Mostafaa-Amiri/smart-indoor-lighting-control-system/hardware/README.md

# Hardware Development

**Smart Indoor Lighting Control System**  
*CST Lab · University of Tehran*

## Overview

This section documents the custom lighting, sensing, control, and measurement hardware developed for the **Smart Indoor Lighting Control System**. It includes three generations of smart LED lighting panels, two LED-driver approaches, networked illuminance and occupancy sensing, capacitive wall switches, and a custom flicker-measurement instrument.

The work combines **circuit and PCB design, embedded electronics, sensing, communication interfaces, thermal design, prototyping, and experimental evaluation**. Implemented hardware and proposed designs are identified in their respective sections. Photographs, PCB renders, schematics, and block diagrams are included throughout.

## Contents

1. [Design approach](#design-approach)
2. [Smart LED lighting panels](#smart-led-lighting-panels)
3. [Smart LED drivers](#smart-led-drivers)
4. [Wi-Fi illuminance sensor](#wi-fi-illuminance-sensor)
5. [Presence sensing](#presence-sensing)
6. [Smart capacitive touch switch](#smart-capacitive-touch-switch)
7. [Flicker measurement device](#flicker-measurement-device)
8. [Related documentation](#related-documentation)

## Design Approach

Although commercial smart luminaires were considered, a custom platform better suited the research requirements:

| Design consideration | Reason for a custom implementation |
|---|---|
| **Research access and control** | Direct access to dimming, electronics and communication signals, without dependence on undocumented vendor interfaces. |
| **Cost and maintainability** | Target lower prototyping costs and enable local replacement and repair of modules. |
| **Long-term availability** | Avoid dependence on a particular manufacturer's product lifecycle or cloud infrastructure. |
| **Supply constraints** | Use accessible parts and alternative sources where importing complete products is difficult. |
| **Design flexibility** | Adjust panel geometry, output power, light distribution, color characteristics and communication architecture for experiments. |
| **System integration** | Maintain control over local communication, sensing, testing and laboratory integration. |

The goal was to develop an adaptable experimental platform with direct access to its **electrical, optical, sensing, and control characteristics**, rather than depend on fixed commercial interfaces.

## Smart LED Lighting Panels

Three principal generations were developed. **V1** explored two LED placement geometries; **V2** prioritized electrical isolation and PWM integrity; **V3** adopted a modular architecture designed for easier fabrication, cooling, servicing and power scaling.

### V1 — Integrated PCB Prototypes

The first generation integrated the **ESP32 Wi-Fi controller**, LED-driver circuitry and LED arrays on a single PCB. An I²C header was provided for connecting illuminance sensors.

Two layouts were explored:

- **Circular arrangement:** square PCB with LEDs positioned in concentric/circular patterns and angled placement.
- **Matrix arrangement:** rectangular PCB with LEDs laid out in a regular grid. The rectangular prototype was approximately **30 × 15 cm**.

This approach offered a compact, self-contained test platform without separate external control boards.

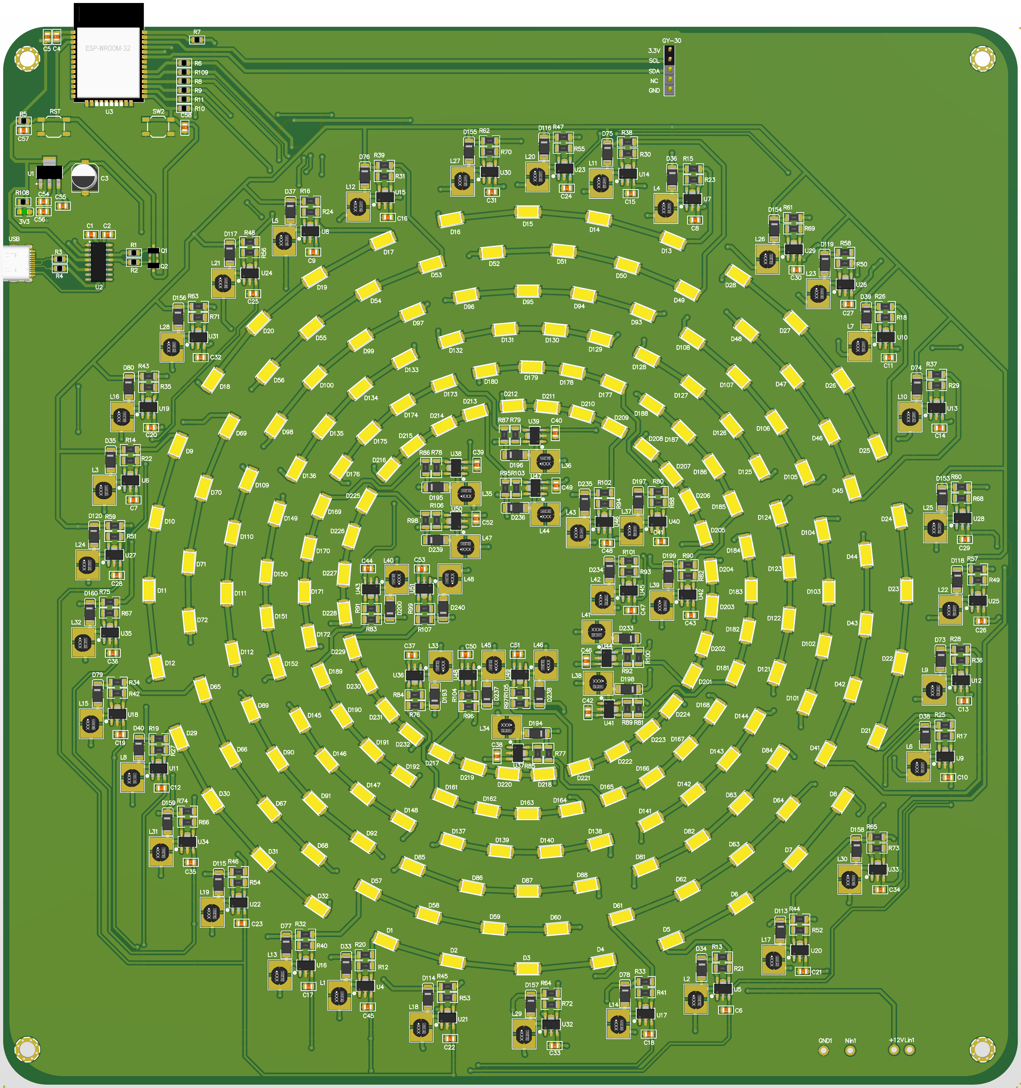
[picture p5: hardware/images/led-panel-v1/pcb-v1-3d-altium.png]
V1 layout A: circular/angled LED arrangement — 3D PCB render


*V1 layout A: circular/angled LED arrangement — 3D PCB render*

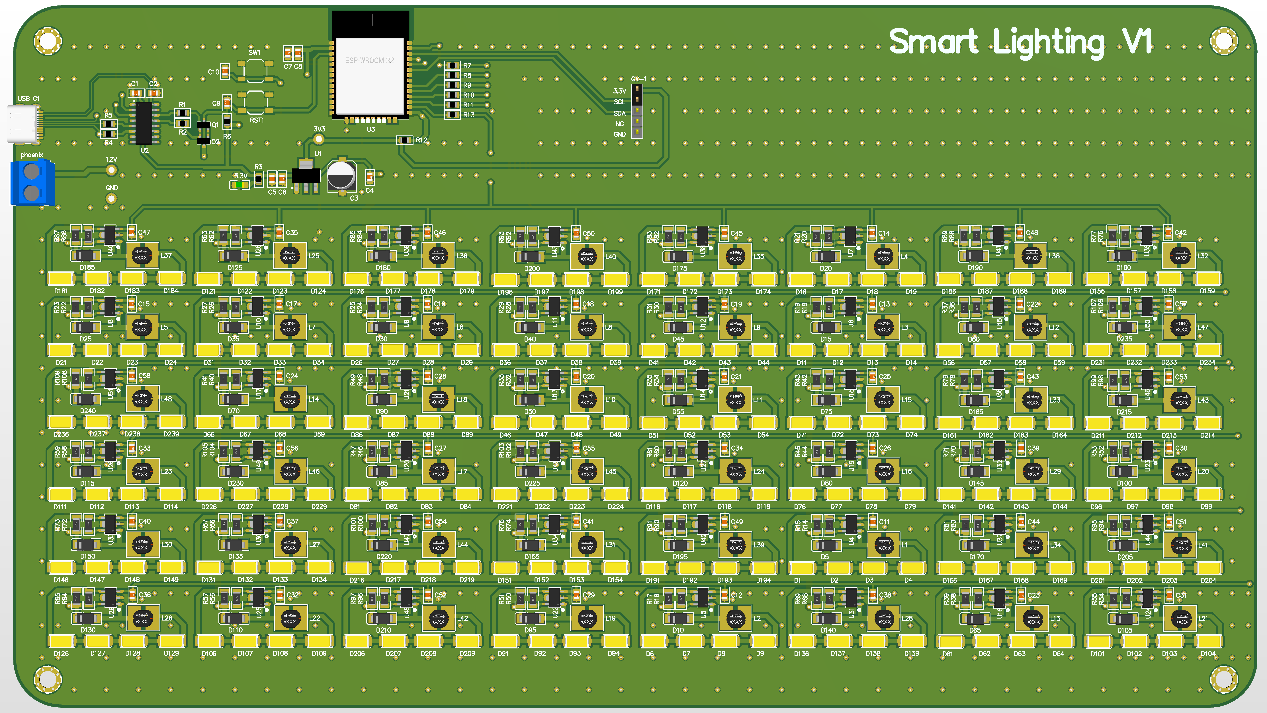
[picture p6: hardware/images/led-panel-v1/pcb-v2-3d-altium.png]
V1 layout B: rectangular LED matrix — 3D PCB render


*V1 layout B: rectangular LED matrix — 3D PCB render*

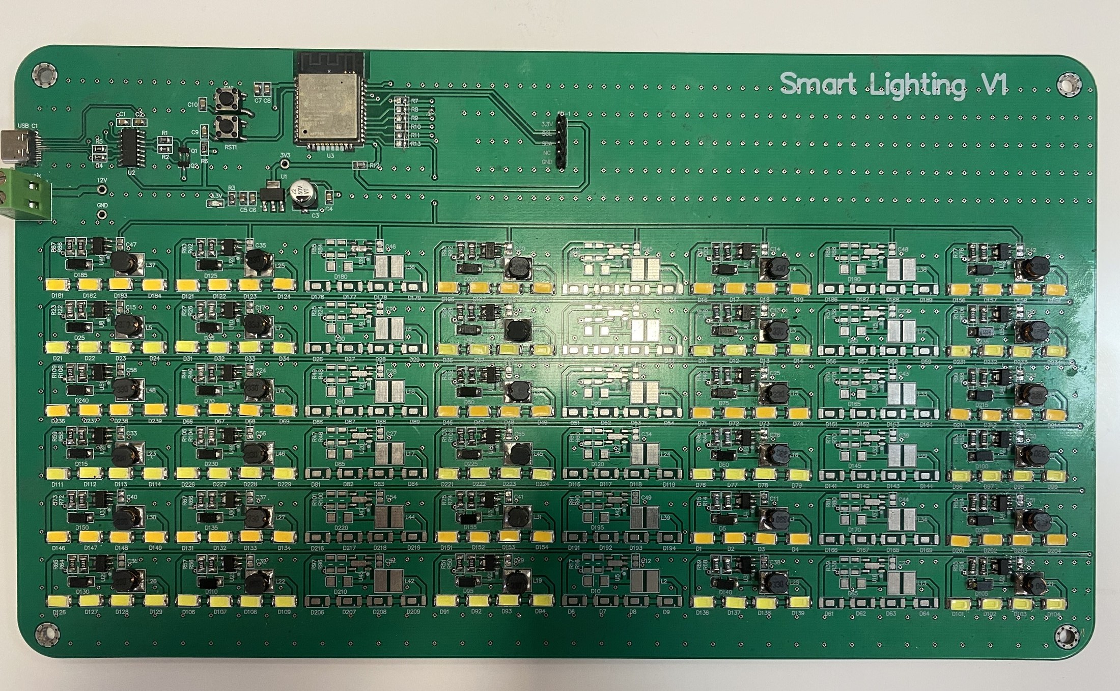
[picture p7: hardware/images/led-panel-v1/assembled-real-pcb.jpg]
First-generation PCB assembly


*First-generation PCB assembly*

**Experimental findings.** In prototype testing, visible flicker was observed and associated with interference involving the on-board Wi-Fi/control circuitry and the driver stages. The single-board architecture made control and power circuitry harder to separate. FR-4 construction without a dedicated heatsink also limited thermal management; the large, densely populated PCB was expensive and time-consuming to assemble and difficult to scale.

<details>
<summary><strong>V1 system diagram and driver schematic</strong> (2 images)</summary>

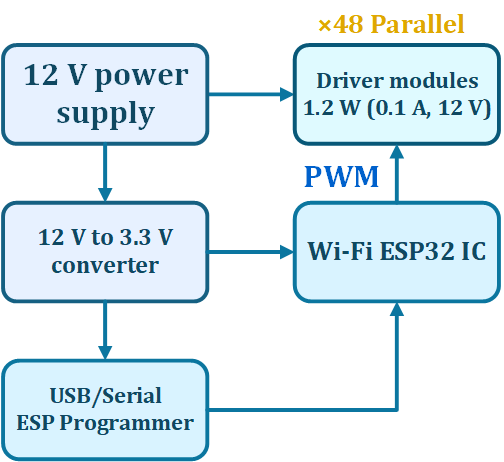
[picture p8: hardware/images/led-panel-v1/block-diagram.png]
V1 integrated power, Wi-Fi control and driver arrangement


*V1 integrated power, Wi-Fi control and driver arrangement*

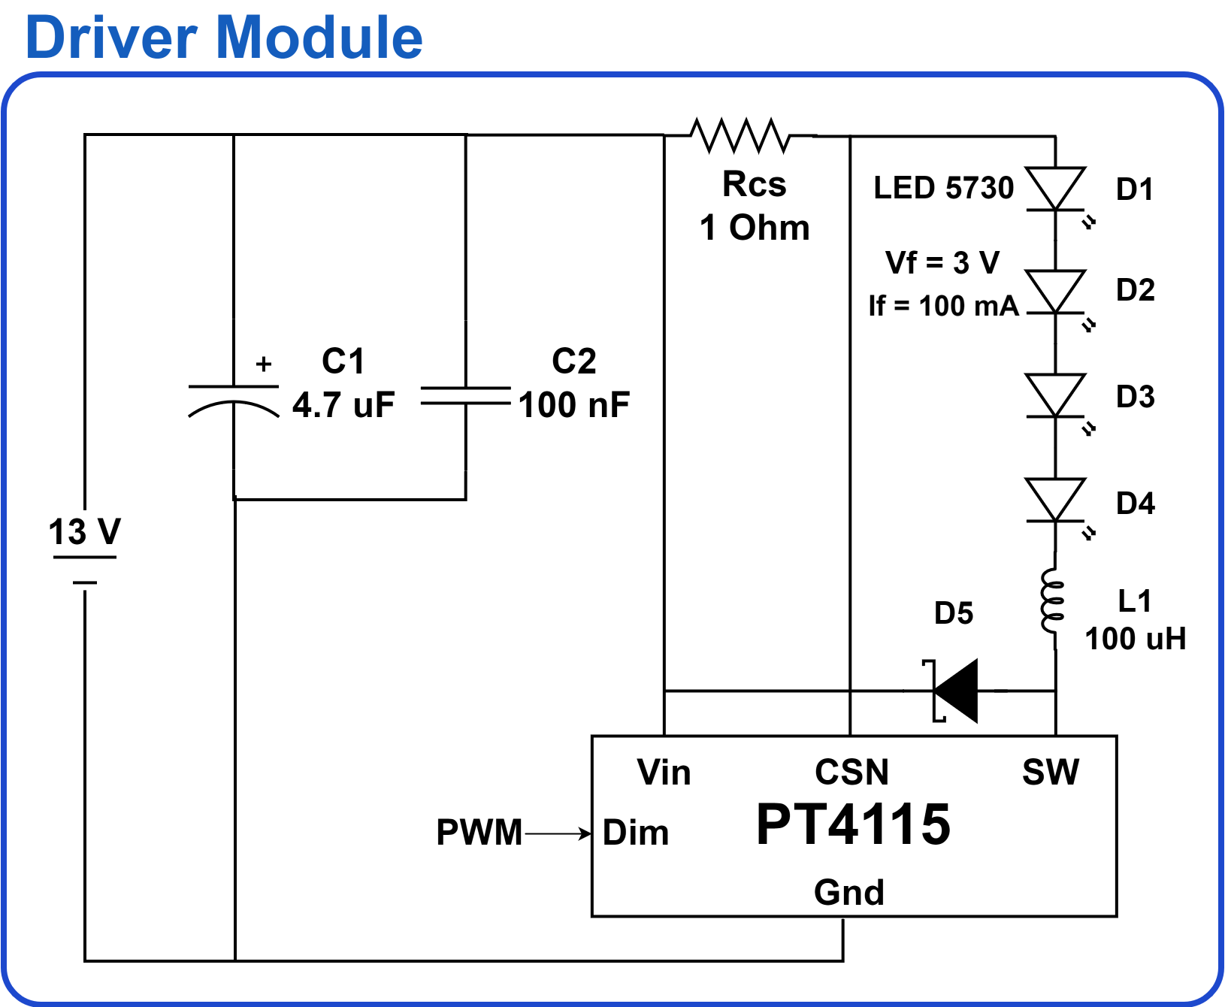
[picture p9: hardware/images/led-panel-v1/circuit-schematic.png]
Representative PT4115 driver circuit supplied for V1


*Representative PT4115 driver circuit supplied for V1*

</details>

### V2 — Isolated Control and Standardized Dimensions

The second generation moved to a **30 × 30 cm** panel and separated the Wi-Fi control electronics from the LED board. The control unit used an **ESP-12F (ESP8266)** instead of ESP32 to reduce cost.

The PWM signal was electrically isolated before reaching the LED board and then distributed through a buffer/line-driver stage. A temperature sensor was also placed on the rear of the board. The controller could **reduce dimming duty cycle (and therefore power) when elevated temperature was detected**.

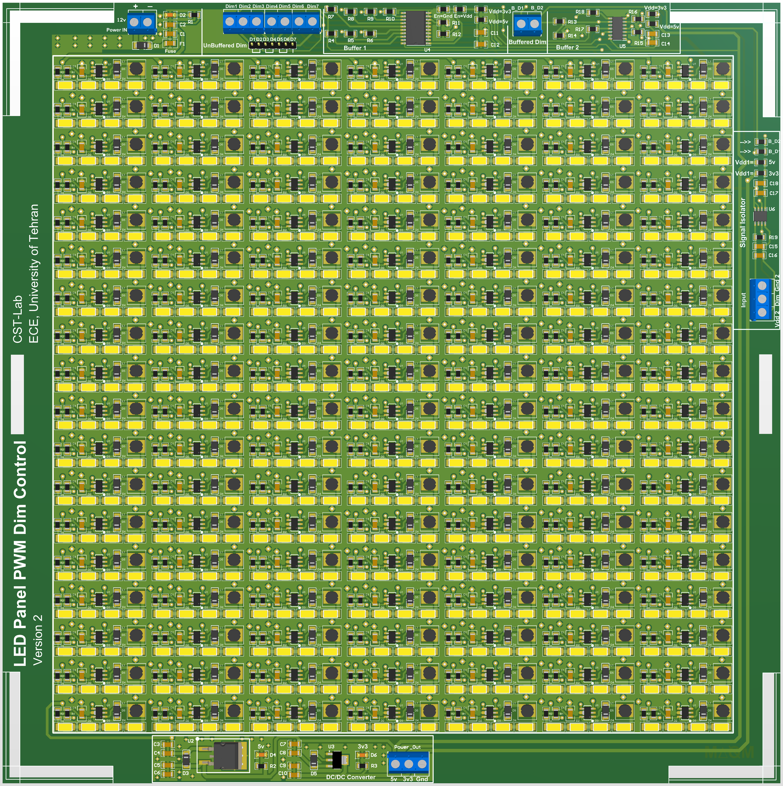
[picture p10: hardware/images/led-panel-v2/pcb-3d-altium.png]
V2 30 × 30 cm panel — Altium 3D PCB render


*V2 30 × 30 cm panel — Altium 3D PCB render*

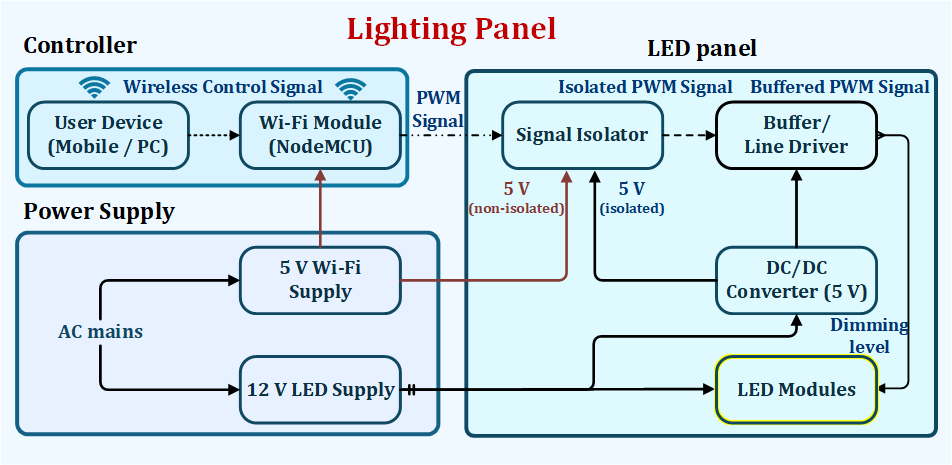
[picture p11: hardware/images/led-panel-v2/block-diagram.png]
V2 isolated Wi-Fi/PWM control and LED-board architecture


*V2 isolated Wi-Fi/PWM control and LED-board architecture*

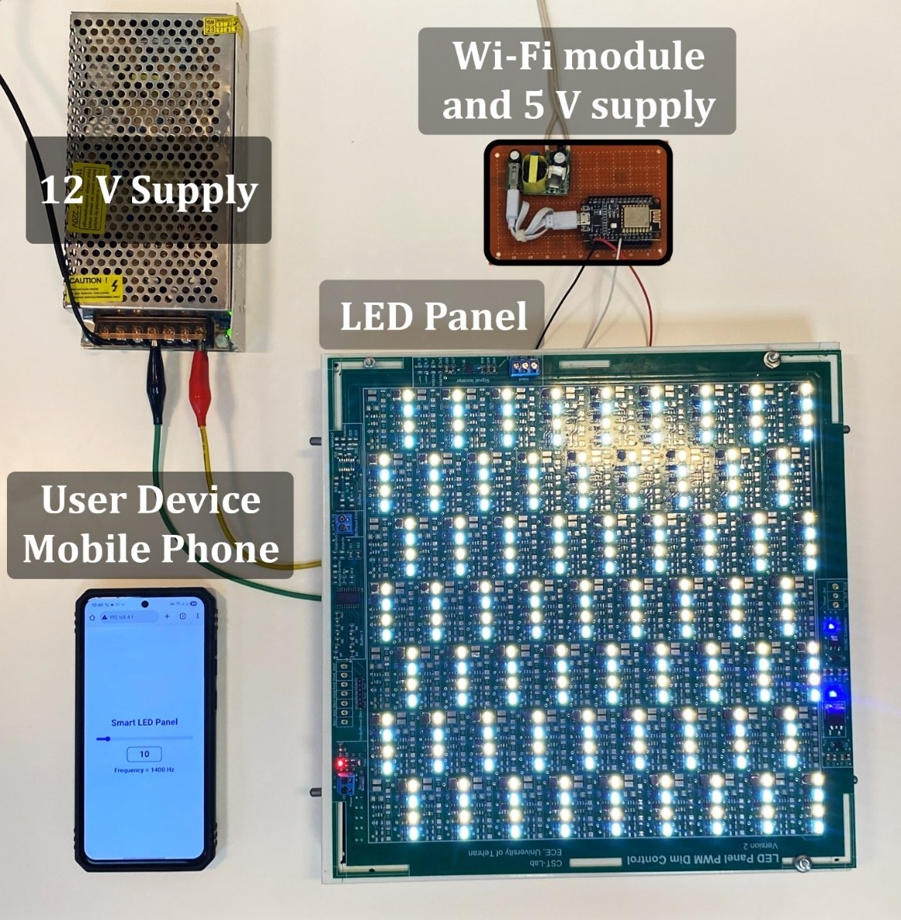
[picture p12: hardware/images/led-panel-v2/working-setup.jpg]
V2 system demonstrator: panel, controller, supply and phone


*V2 system demonstrator: panel, controller, supply and phone*

**Experimental improvements:** the redesign eliminated the previously observed RF-related visible flicker under the tested conditions, improved PWM signal integrity, provided a standard panel form factor and introduced temperature-based power reduction.

**Remaining limitations:** the large PCB, high component count and prolonged assembly made production and repair difficult. Thermal control relied on derating rather than a physical heatsink. The distributed **PT4115** driver stages were not used near their available output capability; project notes indicate approximately **1.2 W per stage**, increasing overall component count.

<details>
<summary><strong>More V2 prototype photos, PCB and schematic</strong> (5 images)</summary>

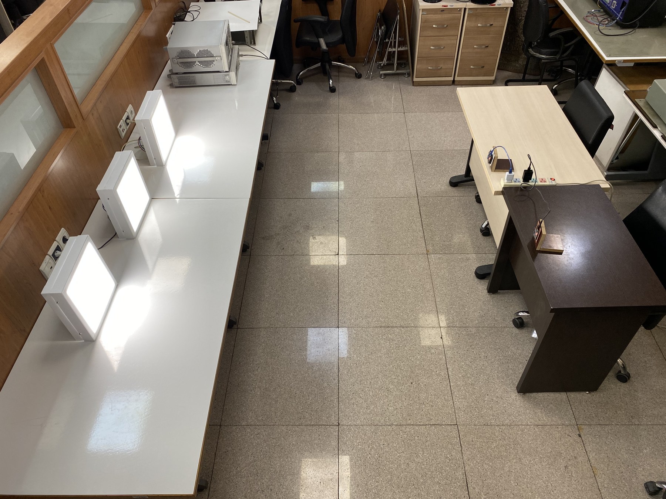
[picture p13: hardware/images/led-panel-v2/3panels-built.jpg]
Three completed panel assemblies


*Three completed panel assemblies*

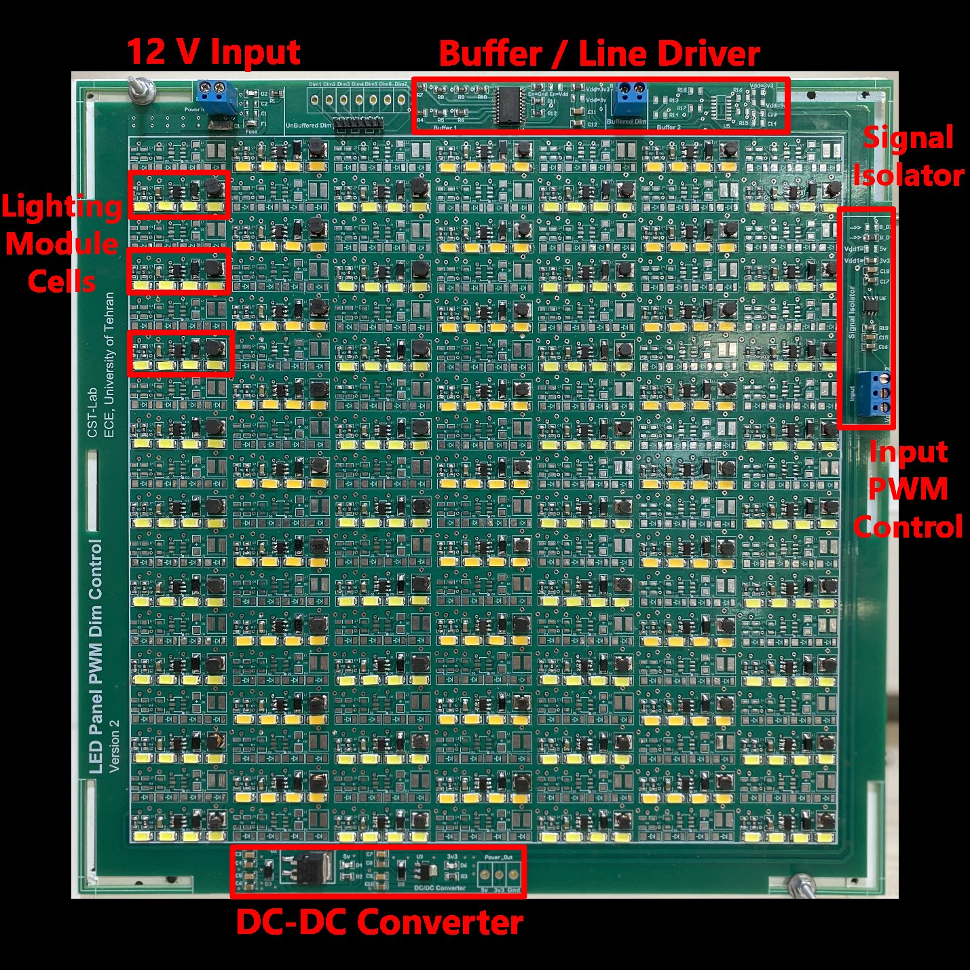
[picture p14: hardware/images/led-panel-v2/assembled-real-pcb.jpg]
Populated second-generation board


*Populated second-generation board*

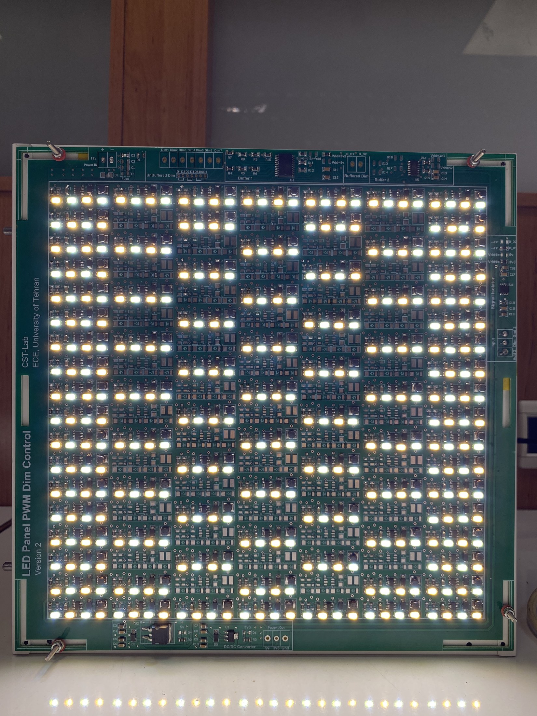
[picture p15: hardware/images/led-panel-v2/assembled-real-pcb-2.jpg]
LED array powered during tests


*LED array powered during tests*

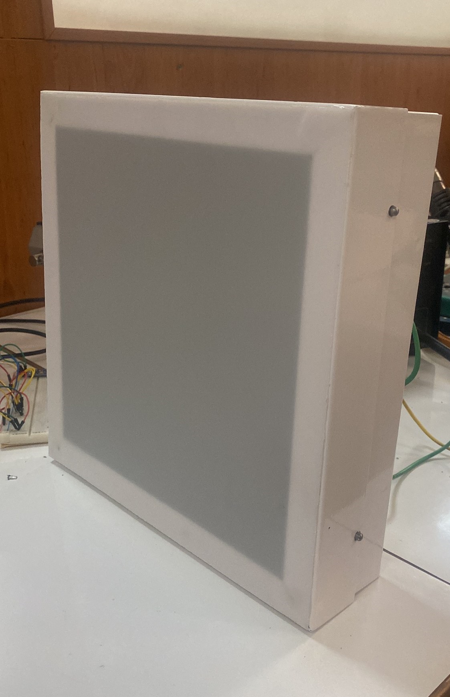
[picture p16: hardware/images/led-panel-v2/single-complete-lighting-panel.jpg]
Complete V2 luminaire with enclosure


*Complete V2 luminaire with enclosure*

Representative PT4115 driver circuit supplied for V2

*Representative PT4115 driver circuit supplied for V2*

</details>

### V3a and V3b — Modular Lighting Panels

The third generation changed the construction approach: instead of mounting many individual LED chips on a custom large-area PCB, it used **commercially available 24 V LED strips (180 LEDs/m)** on a metal heat-dissipation structure, driven by **small replaceable PT4115 constant-current driver modules**.

- **V3a:** **30 × 30 cm**.
- **V3b:** **60 × 30 cm**. The core architecture is shared; the panel size and arrangement differ.

The selected LED strip was described as having **seven series LEDs plus a series resistor per branch**. For the experimental constant-current-driven implementation, the project changed the branch resistor from approximately **180 Ω to 10 Ω** to reduce resistive losses while retaining some series resistance. This is a **prototype modification**, not a general recommendation for operating commercial constant-voltage strips without verifying current-sharing, fault behavior and thermal limits.

The separate PT4115 module was laid out with attention to short switching loops, capacitor placement, inductor/current-sense separation, PWM return routing and provision for heat dissipation.

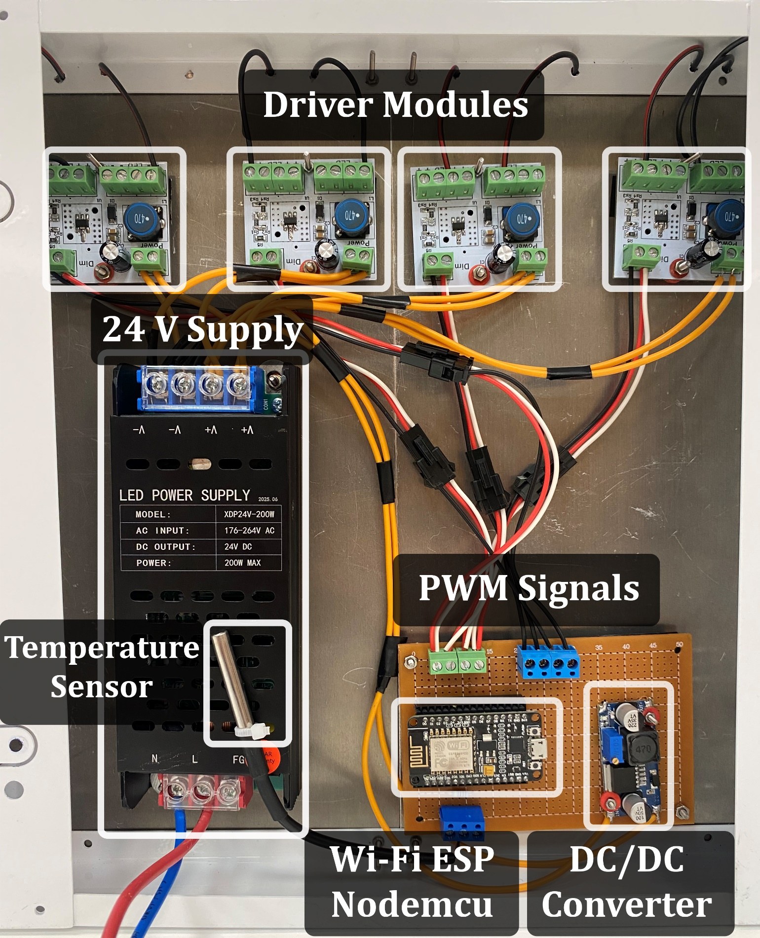
[picture p17: hardware/images/led-panel-v3a/assembled-lighting-panel.jpg]
V3a: complete modular lighting test setup


*V3a: complete modular lighting test setup*

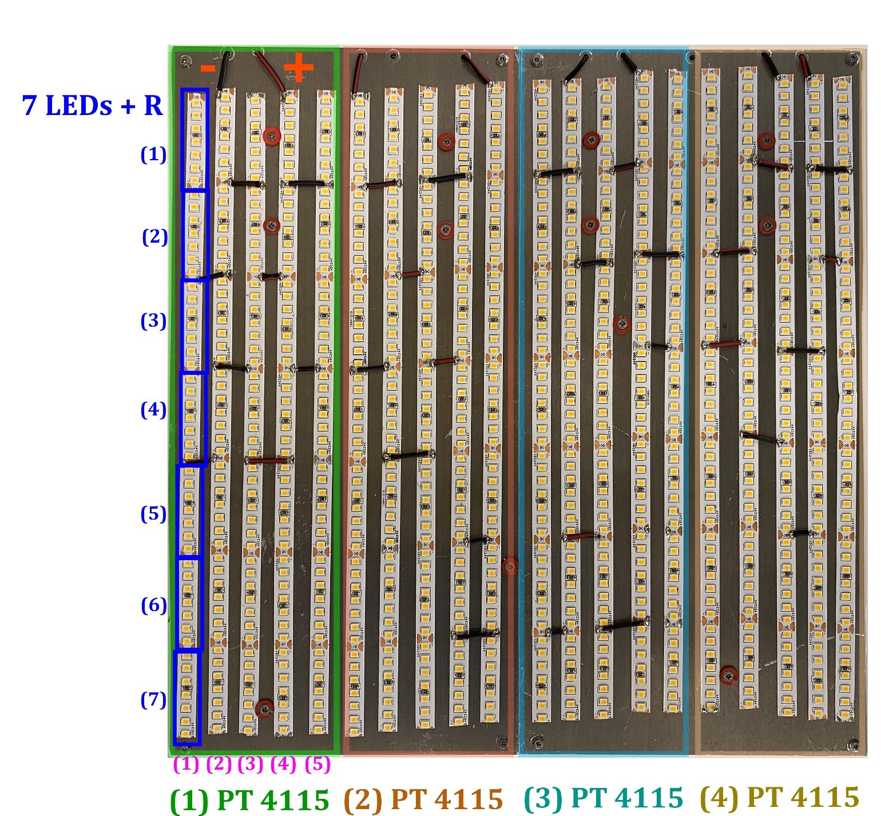
[picture p18: hardware/images/led-panel-v3a/leds-setup.jpg]
V3a: LED strips and distribution among PT4115 driver modules


*V3a: LED strips and distribution among PT4115 driver modules*

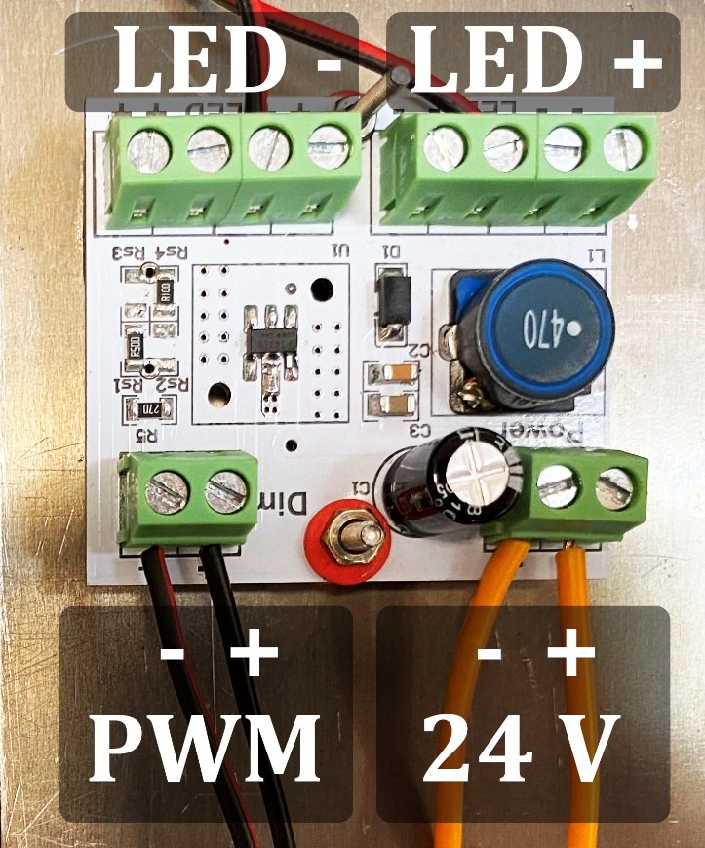
[picture p19: hardware/images/led-panel-v3a/assembled-real-pcb.jpg]
V3: small, assembled PT4115 driver module


*V3: small, assembled PT4115 driver module*

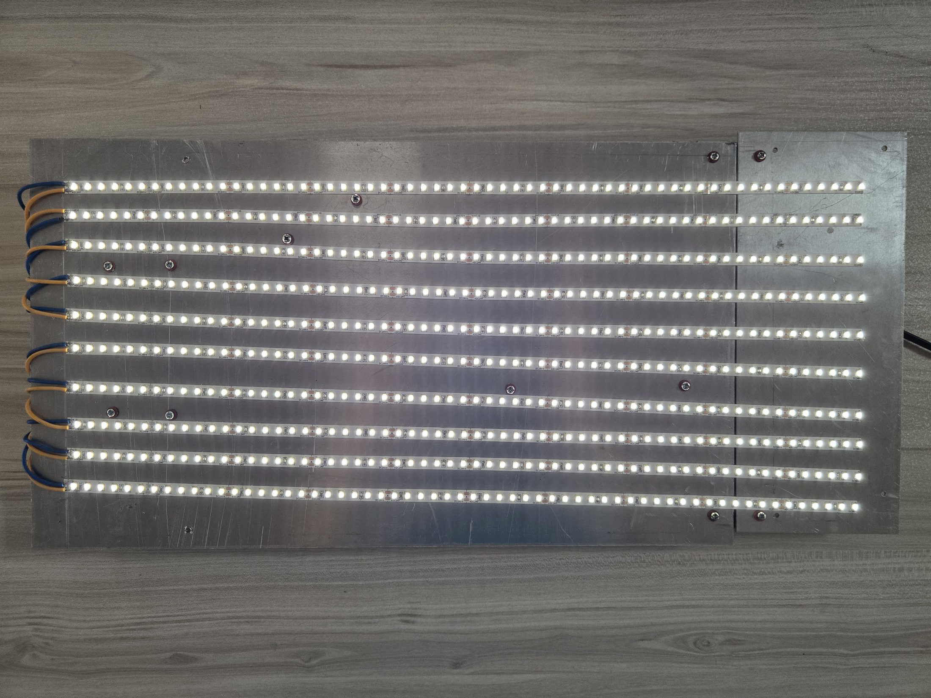
[picture p20: hardware/images/led-panel-v3b/lighting-panel-2.jpg]
V3b: 60 × 30 cm strip-based luminaire


*V3b: 60 × 30 cm strip-based luminaire*

**Engineering improvements:** lower custom-PCB area and assembly effort, simpler replacement of driver modules, heat sinking, and more flexible changes to panel size, power and LED arrangement. A separate-controller architecture also avoided the earlier co-location of Wi-Fi electronics and LED power stages.

<details>
<summary><strong>V3 driver circuit and mechanical views</strong> (2 images)</summary>

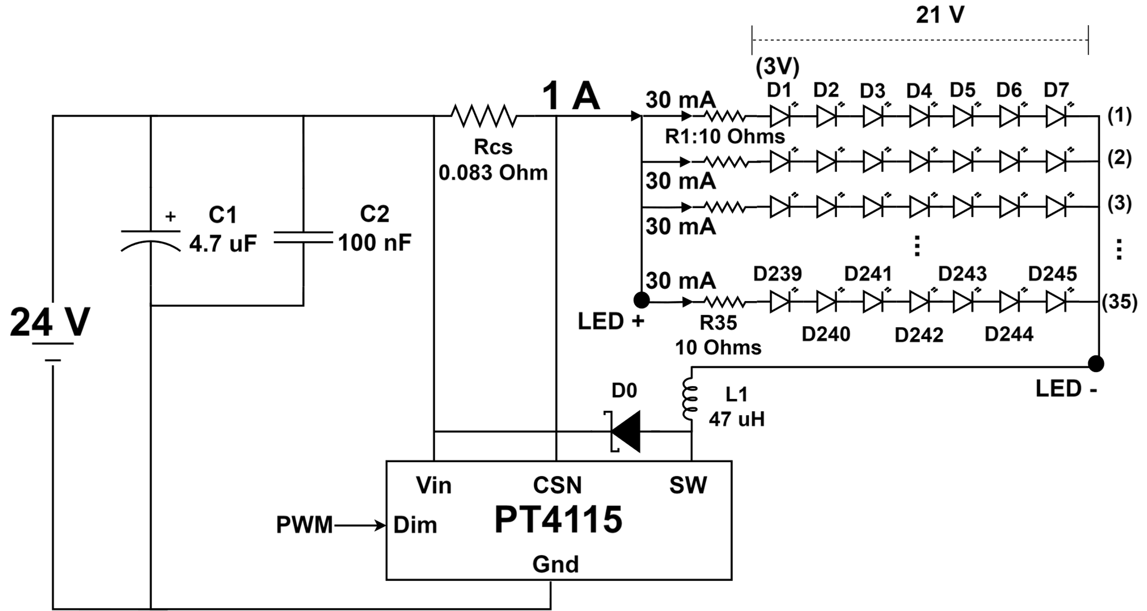
[picture p21: hardware/images/led-panel-v3a/circuit-schematic.png]
Representative V3 constant-current driver/strip branches


*Representative V3 constant-current driver/strip branches*

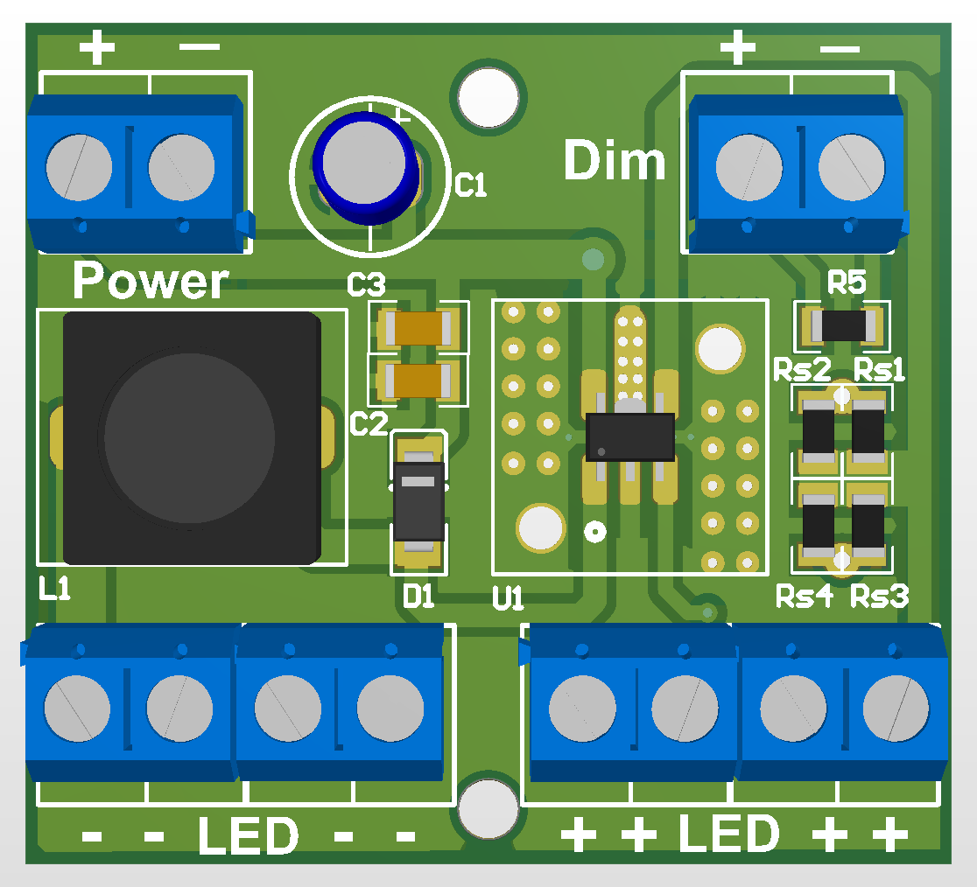
[picture p22: hardware/images/led-panel-v3a/pcb-3d-altium.png]
V3 discrete modular-driver PCB render


*V3 discrete modular-driver PCB render*

</details>

<details>
<summary><strong>V3b rear assembly</strong> (1 image)</summary>

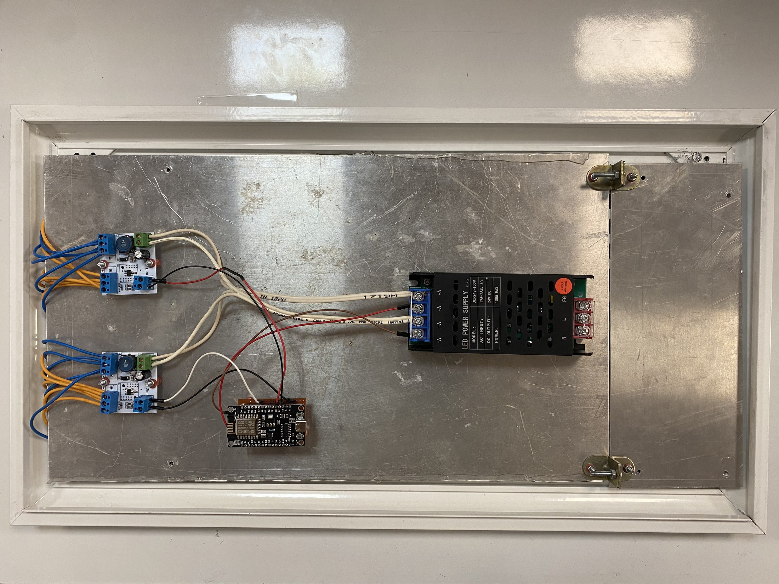
[picture p23: hardware/images/led-panel-v3b/lighting-panel.jpg]
V3b: rear of panel showing driver distribution and wiring


*V3b: rear of panel showing driver distribution and wiring*

</details>

### Experimental Comparison of Panel Generations

The following values come from the project's version-comparison notes. **Illuminance measurements are not directly comparable without documented measurement geometry and conditions**, so they are included here as reported project results rather than standardized performance ratings.

| Parameter | V1 | V2 | V3 family |
|---|---:|---:|---:|
| Reported panel power | 18 W | 36 W | 100 W |
| Reported illuminance | 120 lx | 300 lx | 650 lx |
| Thermal approach | No dedicated control | Temperature monitoring and power derating | Temperature monitoring, derating and physical heatsink |
| Visible RF-related flicker in project tests | Observed | Not observed after redesign | Not observed in reported tests |
| Reported assembly time | 2 days | 3.5 days | 1 day |
| Repairability | Difficult | Difficult | Modular replacement |
| Production suitability (qualitative) | Low | Low | Improved |

The project also recorded relative cost estimates of **4.0 million, 5.5 million, and 3.5 million** in local currency for V1, V2, and V3, respectively. These are prototype cost estimates rather than commercial quotations.

## Smart LED Drivers

Beyond building complete lighting panels, another objective was a **retrofit path for making suitable commercially available LED panels controllable via custom Wi-Fi PWM electronics**.

### Preliminary MOSFET-Based PWM Test

An initial low-cost test circuit served as a proof of concept. It used an ESP-generated PWM command and a MOSFET switching stage. **Series resistance** was used to limit LED current, including current changes associated with temperature. It was **not a regulated constant-current driver**, and therefore was not the preferred final architecture.

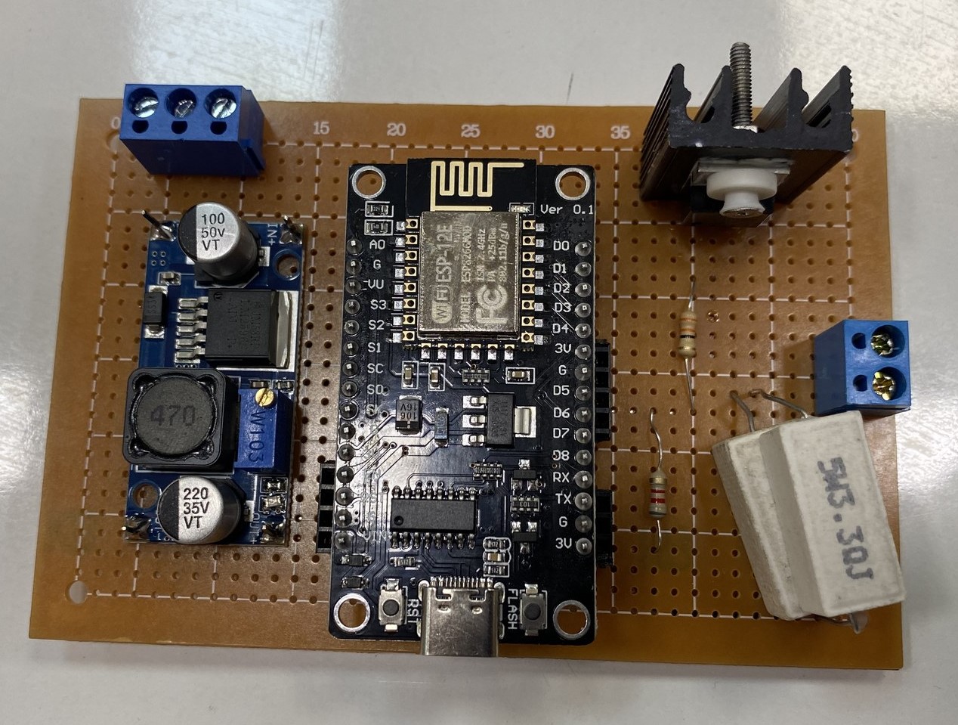
[picture p24: hardware/images/smart-driver-v1/assembled.jpg]
First low-cost PWM/MOSFET LED switching prototype


*First low-cost PWM/MOSFET LED switching prototype*

### Smart LED Lighting Panel Driver — Wi-Fi Constant-Current Design

The smart lighting panel driver integrates a high-power **constant-current LED-driver IC**, an **ESP-12F (ESP8266) Wi-Fi controller**, and an on-board **3.3 V regulator** to provide adjustable dimming for compatible LED loads. **The PCB has now been fabricated, assembled, and functionally tested with an LED lighting panel**, progressing beyond the Altium design stage.

**Electrical design parameters and control features:**

- **Input supply range:** approximately **5–60 V**, subject to device, regulator and component operating limits.
- **LED output current:** configurable **up to 2 A**, subject to electrical and thermal derating.
- **Control:** Wi-Fi-based dimming using the embedded controller.
- **Current-setting:** sense/configuration resistors set the target **LED current**. In a constant-current design, the LED-string voltage is determined by the load and available converter operating range; it is **not independently programmable by a resistor**.
- **Protection objectives:** undervoltage lockout, overcurrent and thermal protection, open/short-load handling, and controlled startup, as applicable to the selected circuitry and driver IC. These features must be verified against the final schematic and test results; they are not claimed here as independently certified.

<p align="center">
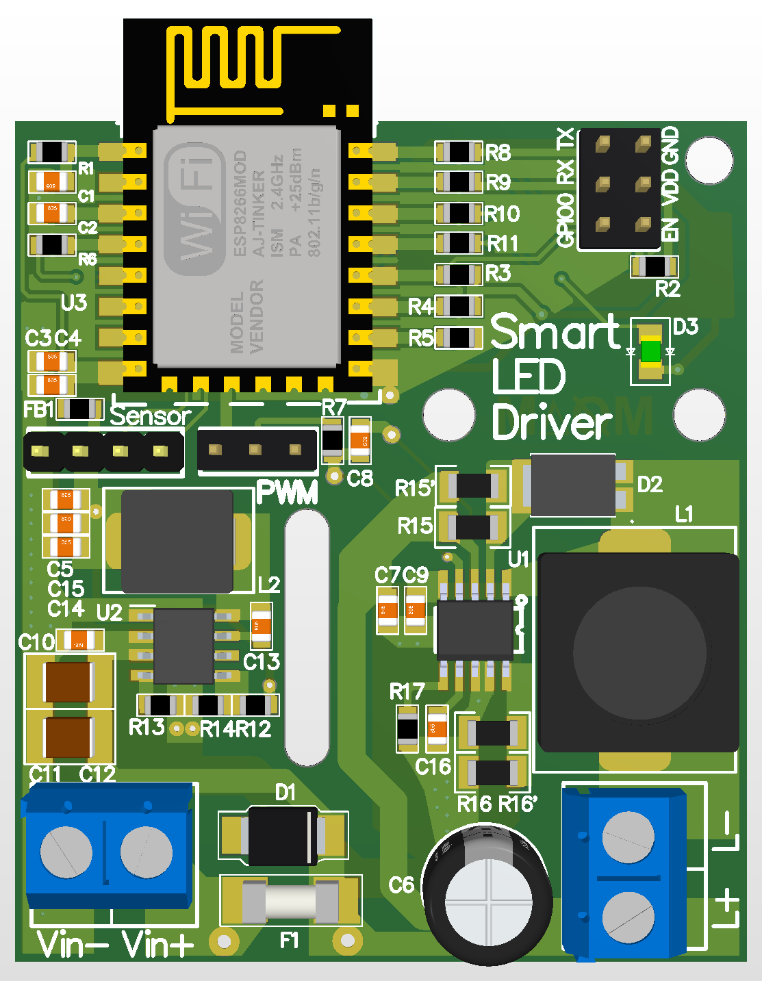
[picture p25: hardware/images/smart-driver-v2/pcb-3d-altium.png]
Altium 3D rendering of the smart LED lighting panel driver PCB
  
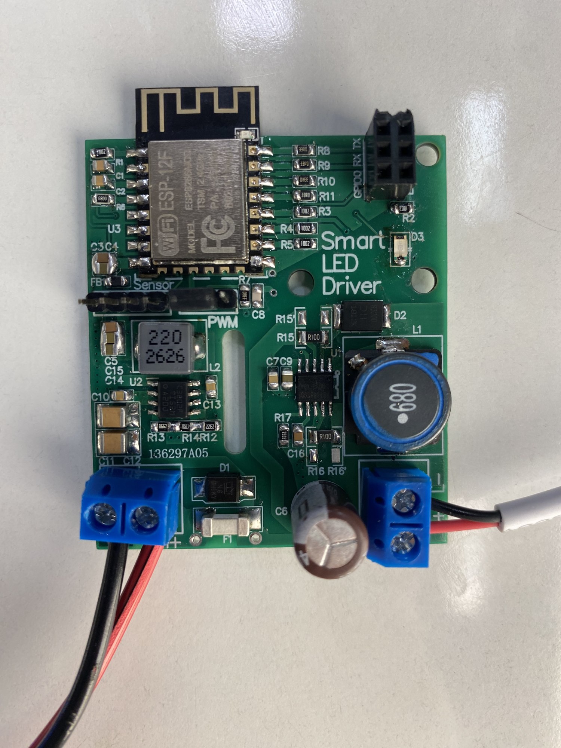
[picture p26: hardware/images/smart-driver-v2/assembled-front.jpg]
Assembled smart LED lighting panel driver PCB, component side
  
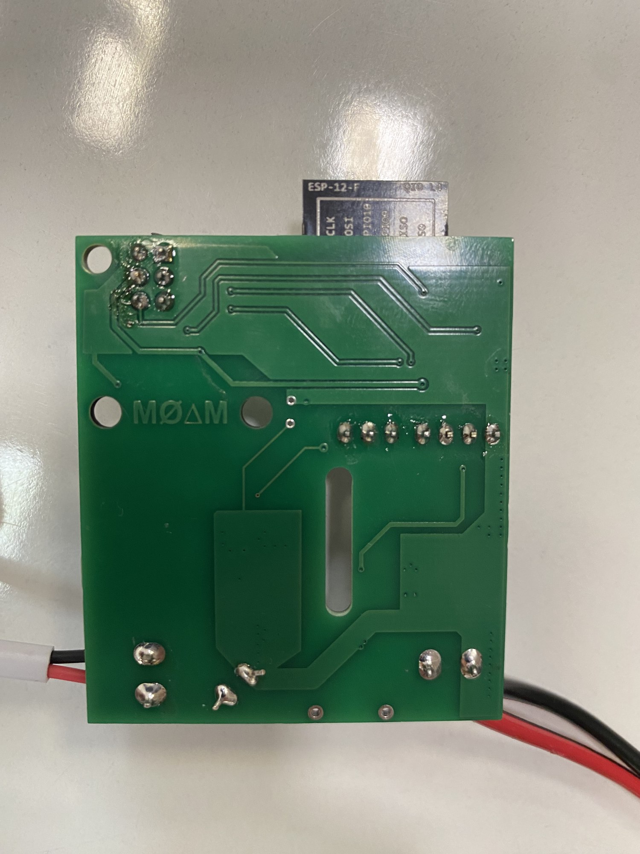
[picture p27: hardware/images/smart-driver-v2/assembled-back.jpg]
Assembled smart LED lighting panel driver PCB, solder side
  
</p>

<p align="center"><em>Smart LED lighting panel driver: Altium PCB visualization (left), assembled component side (center), and solder side (right).</em></p>

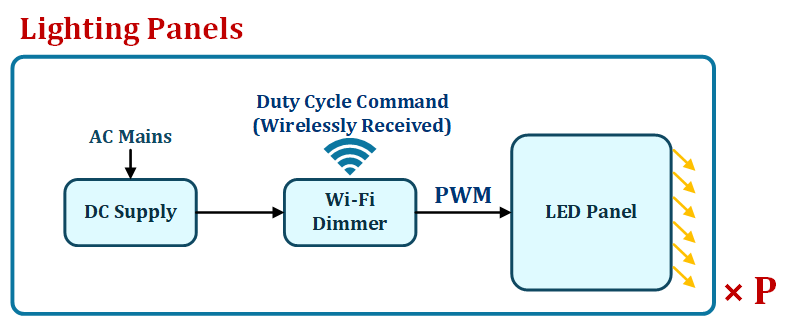
[picture p28: hardware/images/smart-driver-v2/block-diagram.png]
Wireless PWM dimming and LED-panel connection concept


*Wireless PWM dimming and LED-panel connection concept*

#### Assembly and Functional Demonstration

The assembled driver was evaluated with a connected LED panel. The photographs document the populated circuit board and the operating test setup; the accompanying video demonstrates the panel's dimming behavior. The demonstration establishes functional operation of this prototype, while the electrical ratings listed above describe design parameters rather than a fully characterized operating envelope.

<p align="center">
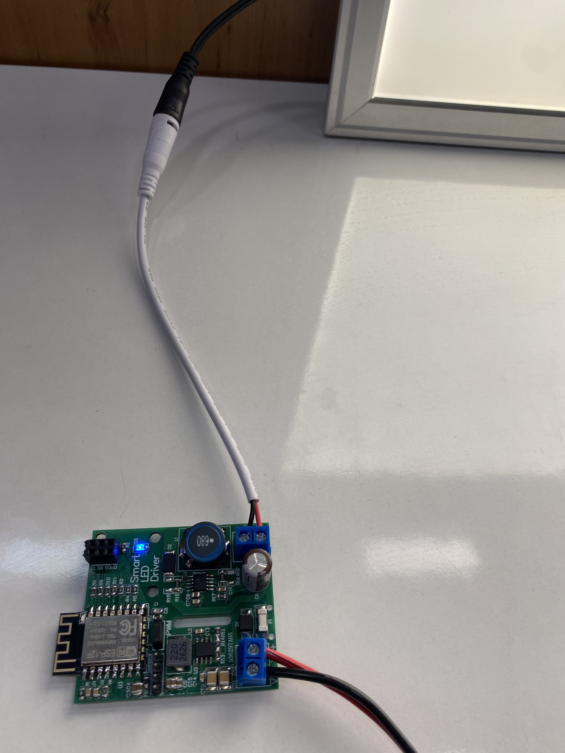
[picture p29: hardware/images/smart-driver-v2/working-test-setup-1.jpg]
Smart LED lighting panel driver connected to the LED panel during a functional test
  
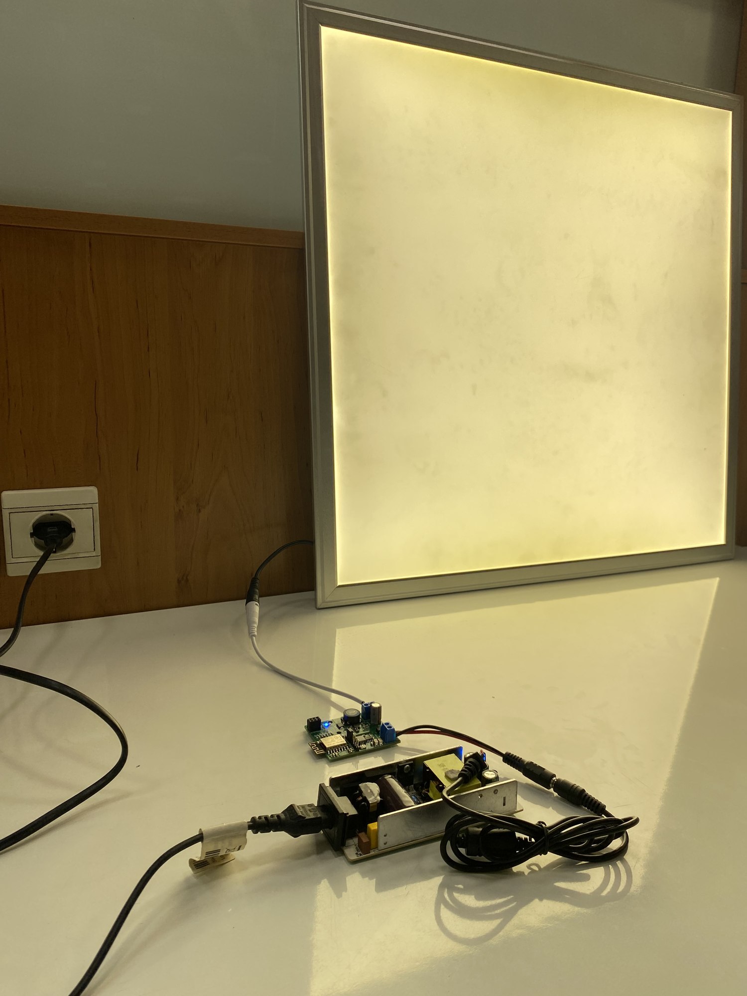
[picture p30: hardware/images/smart-driver-v2/working-test-setup-2.jpg]
Working LED panel illuminated by the assembled smart driver; click to watch the dimming demonstration
  
</p>

<p align="center"><em>Functional test of the assembled driver with an LED panel. Click the photograph on the right to watch the demonstration.</em></p>

**[Watch the smart LED lighting panel driver demonstration on YouTube](https://youtube.com/shorts/y5qzMRnB7PI?feature=share)**

## Wi-Fi Illuminance Sensor

A simple networked illuminance node uses a **BH1750/GY-30 digital lux sensor** with a **NodeMCU (ESP8266)**. The microcontroller acquires multiple illuminance samples, averages or filters the readings, and transmits them to the central gateway/controller for daylight estimation and feedback control.

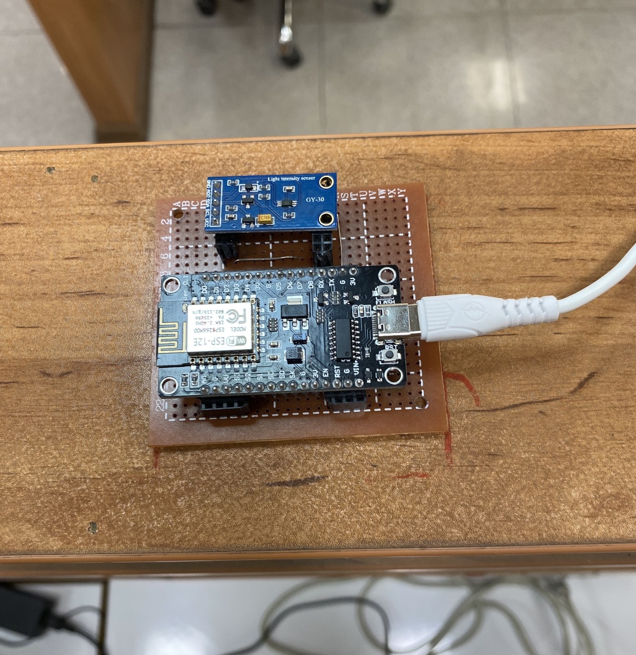
[picture p31: hardware/images/illuminance-sensor/bh1750-esp.jpg]
BH1750/GY-30 and NodeMCU Wi-Fi illuminance node


*BH1750/GY-30 and NodeMCU Wi-Fi illuminance node*

## Presence Sensing

Occupancy feedback was investigated using **mmWave radar** and **camera-based detection**. Both approaches support adaptive lighting decisions, but they have different measurement capabilities and privacy implications.

### Wi-Fi mmWave Radar Sensors

**HLK-LD2420** and **HLK-LD2450** radar modules were integrated as networked occupancy-sensing nodes. The LD2420 implementation uses an ESP8266/NodeMCU, while the LD2450 implementation uses an **ESP32** to process radar data and communicate occupancy states to the central controller.

- **LD2420:** presence and small-motion detection; the module was used for **single-target presence detection**, not multi-person tracking.
- **LD2450:** supports tracking information for **up to three targets**, including estimated positions under suitable conditions.
- **Benefit:** mmWave sensing can respond to small movements from otherwise stationary occupants, addressing some limitations of simple motion-triggered sensing.

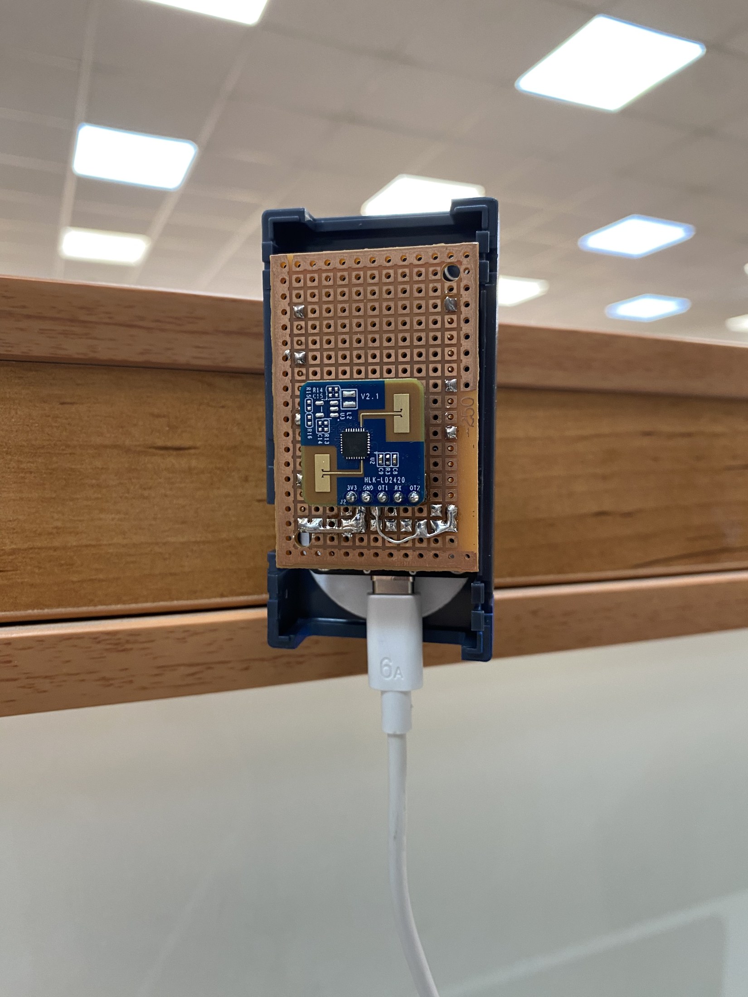
[picture p32: hardware/images/radar-presence-sensor/ld2420-esp.jpg]
LD2420 radar sensor with ESP/NodeMCU module


*LD2420 radar sensor with ESP/NodeMCU module*

#### LD2450–ESP32 Enclosed Sensor Assembly

The photographs below show the assembled **LD2450 radar and ESP32 sensing node**, including the internal electronics and the installed enclosure. Its associated firmware handles target information and publishes occupancy status to the lighting-control system.

<p align="center">
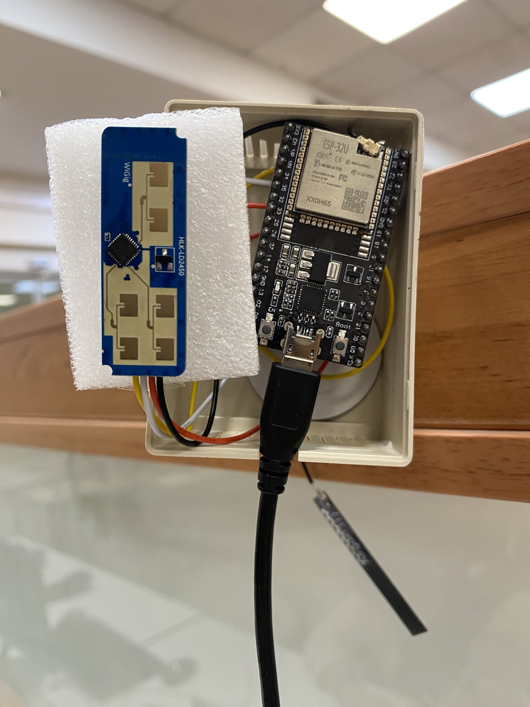
[picture p33: hardware/images/radar-presence-sensor/ld2450-esp32-open-enclosure.jpg]
LD2450 radar and ESP32 presence sensor inside the opened housing
  
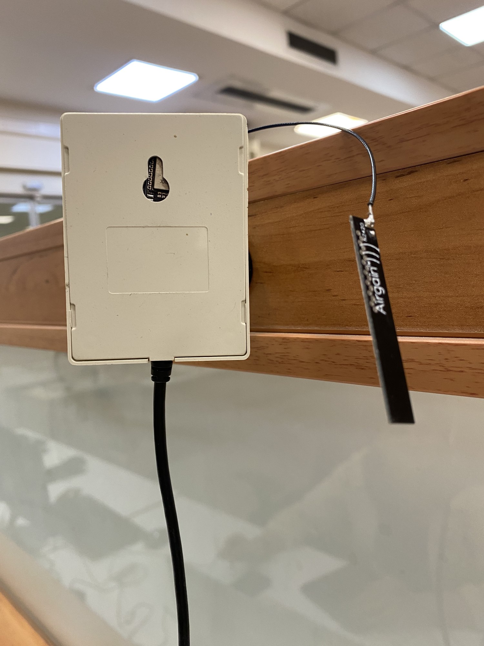
[picture p34: hardware/images/radar-presence-sensor/ld2450-esp32-closed-enclosure.jpg]
Enclosed LD2450 and ESP32 presence sensing module
  
</p>

<p align="center"><em>LD2450–ESP32 occupancy-sensing module: internal assembly (left) and closed enclosure (right).</em></p>

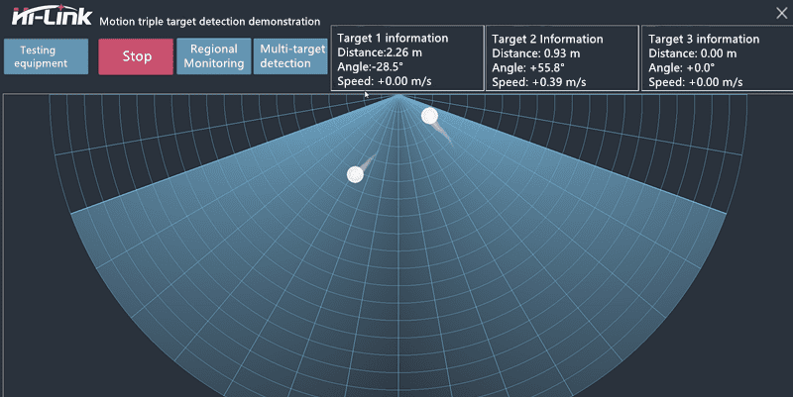
[picture p35: hardware/images/radar-presence-sensor/hilink-ui-app.png]
Hi-Link visualization of detected target positions


*Hi-Link visualization of detected target positions from the LD2450 radar sensor.*

[View the LD2450 ESP32 firmware](../firmware/README.md#multi-radar-occupancy-sensor--ld2450)

### Raspberry Pi Camera and YOLO

An alternative prototype used a **Raspberry Pi 3 with camera** and **YOLO-based people detection**. Camera-based detection can support vision-based occupancy analysis, but it creates **privacy and data-handling requirements** that do not arise in the same way with non-imaging radar. For a deployment, on-device inference, image-retention policies and user consent must be considered.

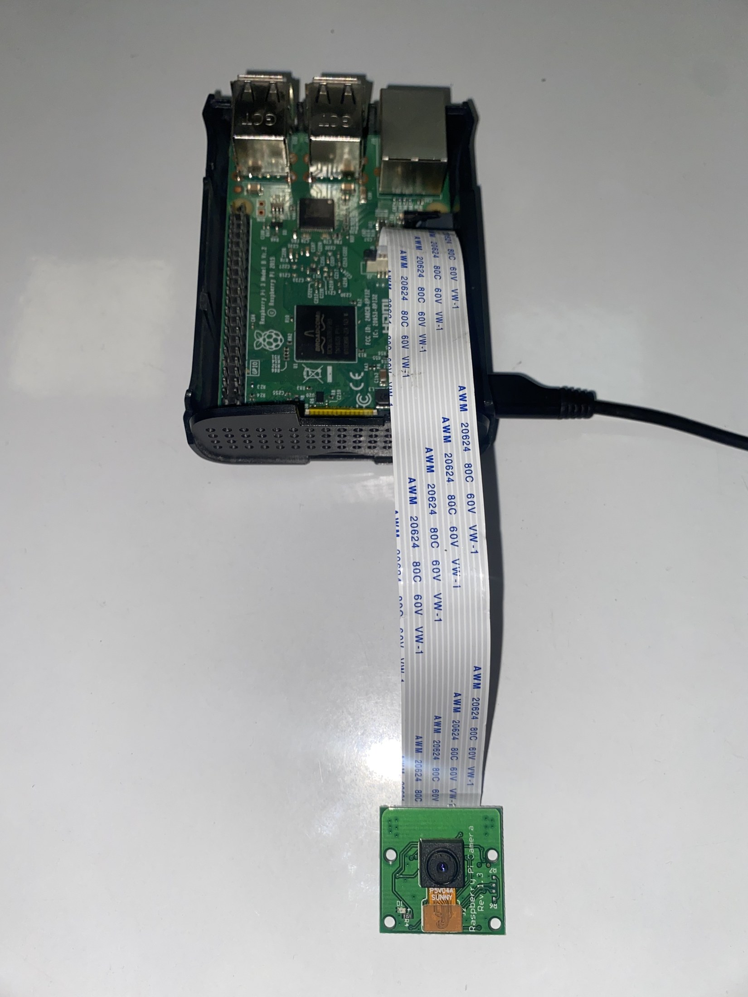
[picture p36: hardware/images/camera-presence-sensor/rbpi3-camera.jpg]
Raspberry Pi 3 and camera hardware for YOLO presence detection


*Raspberry Pi 3 and camera hardware for YOLO presence detection*

### ESP32-CAM Image Acquisition Node

An **ESP32-CAM** module was also implemented as a compact Wi-Fi camera node for the occupancy-detection pipeline. Its firmware provides JPEG image capture and HTTP access; computer-vision inference is performed separately from the embedded camera application.

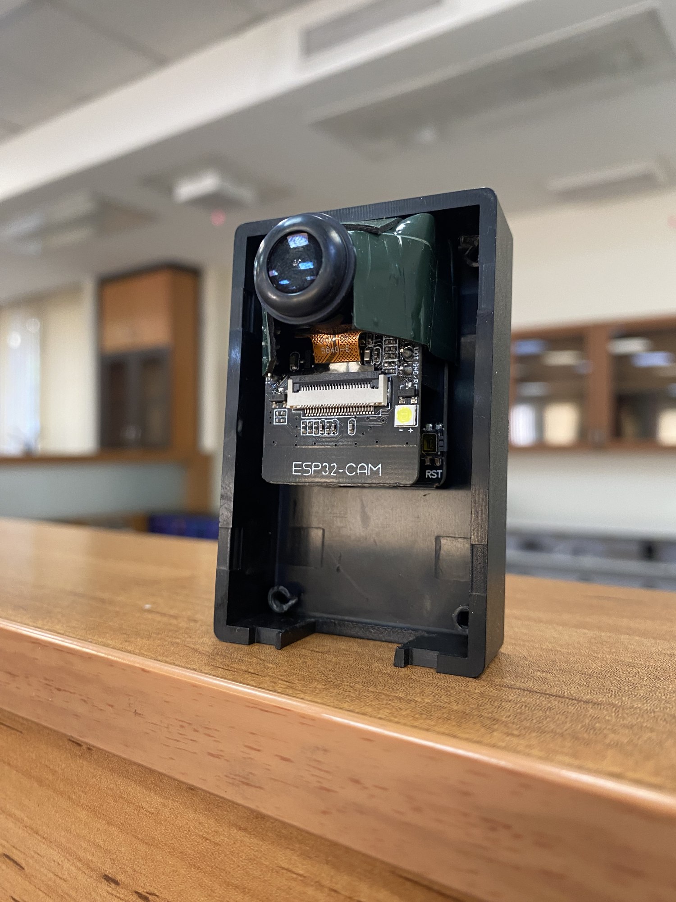
[picture p37: hardware/images/camera-presence-sensor/esp32-cam-enclosure.jpg]
ESP32-CAM image-acquisition module installed in its enclosure


*Physical ESP32-CAM imaging node mounted in its enclosure.*

[View the ESP32-CAM firmware](../firmware/README.md#esp32-cam--image-acquisition)

## Smart Capacitive Touch Switch

A custom **up-to-three-gang capacitive touch switch** was designed for local and Wi-Fi-enabled lighting control. The assembly integrates a touch/ESP control board with an appropriate mains-interface/power-board configuration. Designs were explored for installations **with and without a neutral conductor** (the photos and PCB renders document both variants).

The objective was to combine physical wall-switch operation with remote/app-based control for the smart-lighting system.

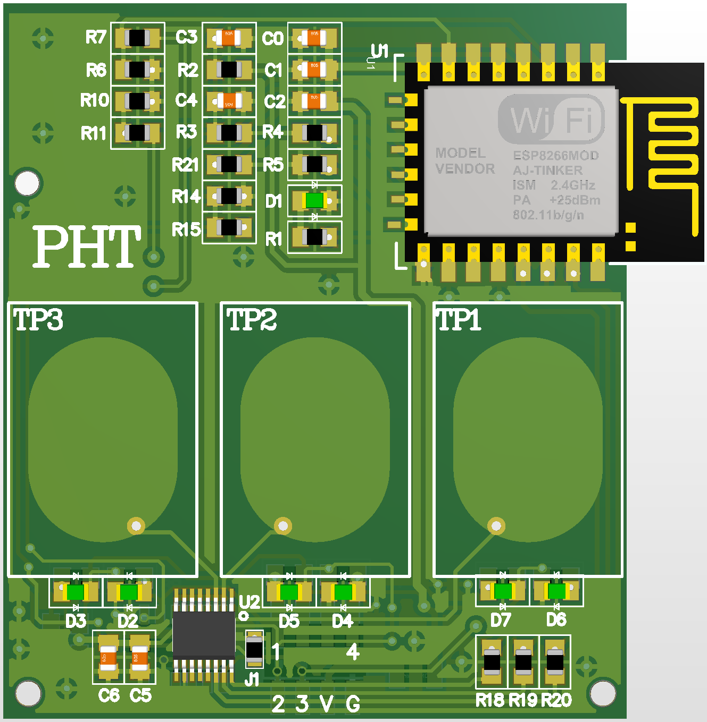
[picture p38: hardware/images/smart-touch-switch/pcb-touch-esp-3d-altium-1.png]
3-gang capacitive touch and ESP PCB render


*3-gang capacitive touch and ESP PCB render*

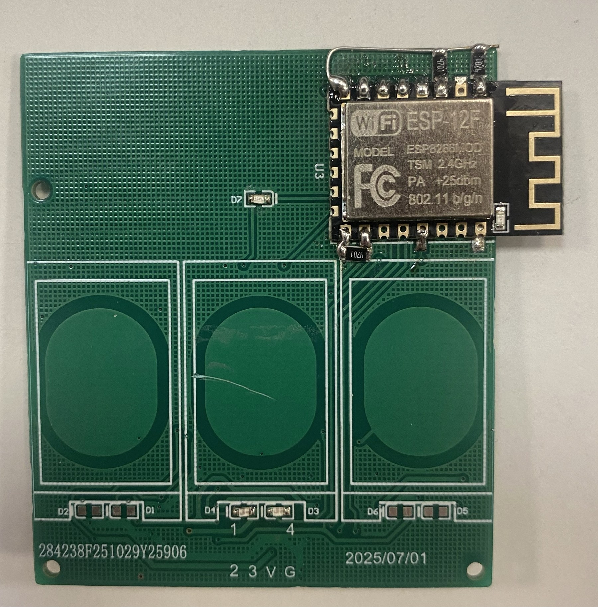
[picture p39: hardware/images/smart-touch-switch/assembled-1.jpg]
Assembled Wi-Fi capacitive touch board


*Assembled Wi-Fi capacitive touch board*

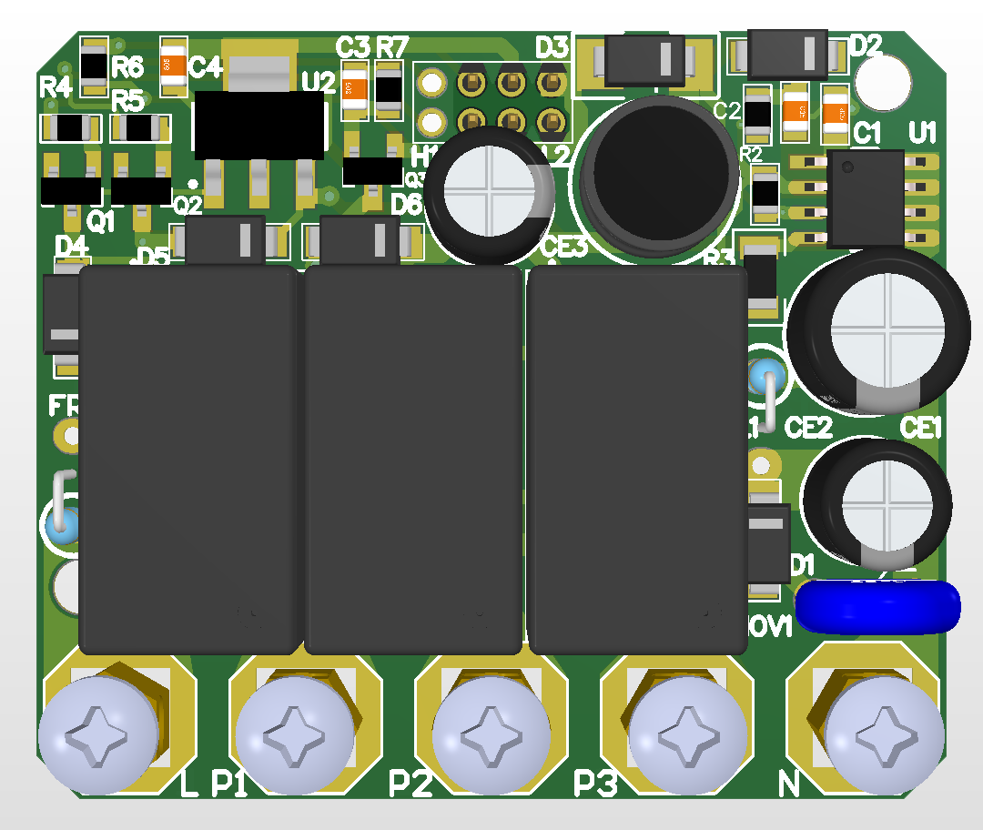
[picture p40: hardware/images/smart-touch-switch/pcb-powerboard-nullrequired-3d-altium.png]
Mains power board — neutral required


*Mains power board — neutral required*

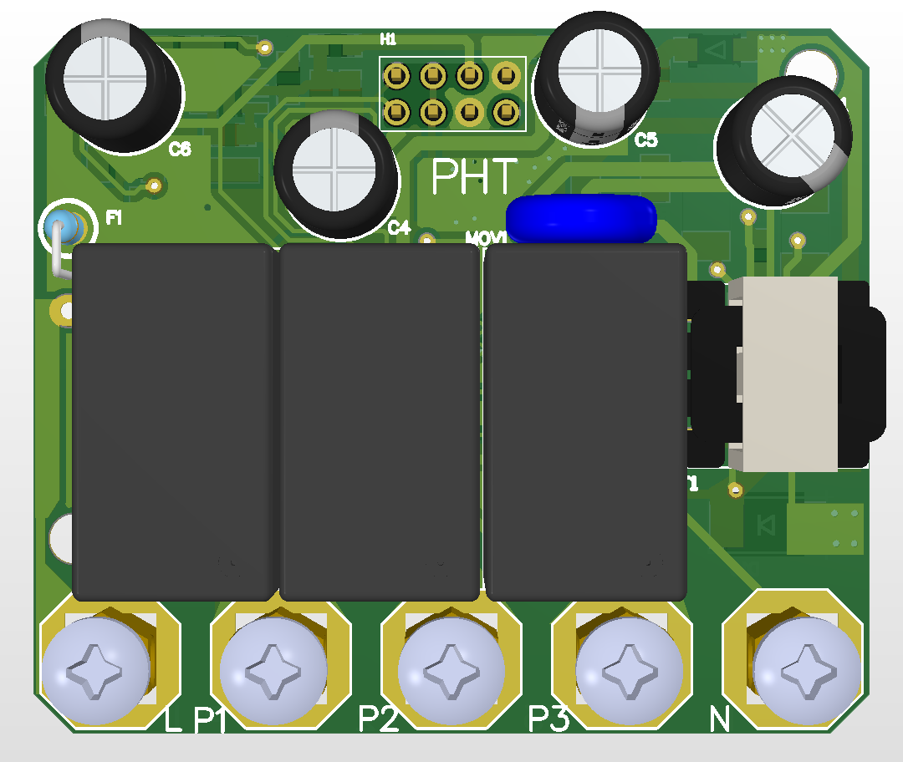
[picture p41: hardware/images/smart-touch-switch/pcb-powerboard-nonullrequired-3d-altium-1.png]
Mains power board — no neutral required


*Mains power board — no neutral required*

<details>
<summary><strong>Additional switch photographs and PCB renders</strong> (5 images)</summary>

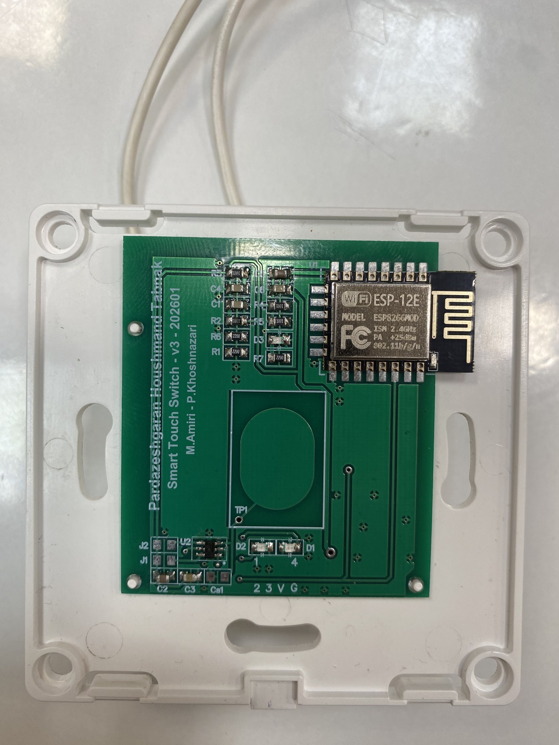
[picture p42: hardware/images/smart-touch-switch/assembled-2.jpg]
Touch board mounted in switch enclosure


*Touch board mounted in switch enclosure*

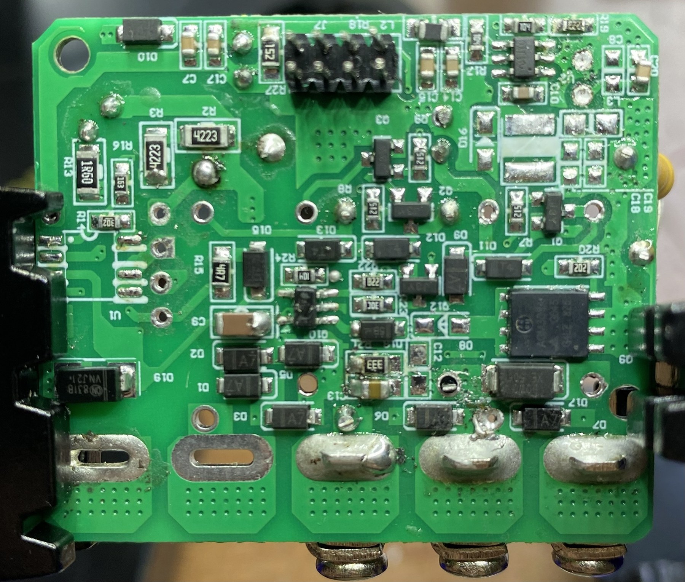
[picture p43: hardware/images/smart-touch-switch/assembled-powerboard-no-null-required.jpg]
Assembled no-neutral power board


*Assembled no-neutral power board*

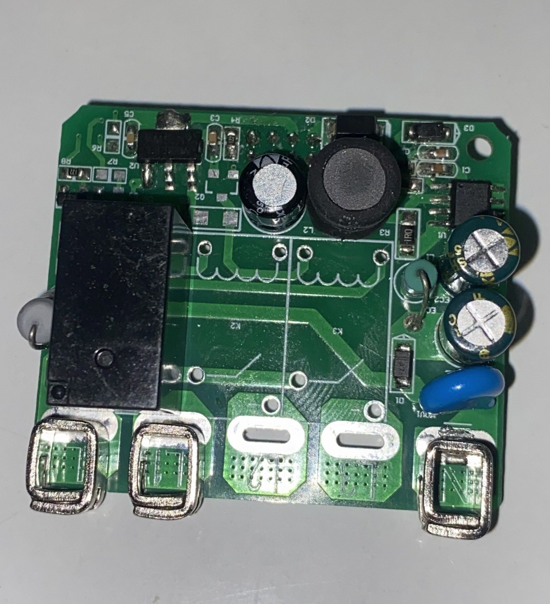
[picture p44: hardware/images/smart-touch-switch/assembled-powerboard-null-required.jpg]
Assembled neutral-required power board


*Assembled neutral-required power board*

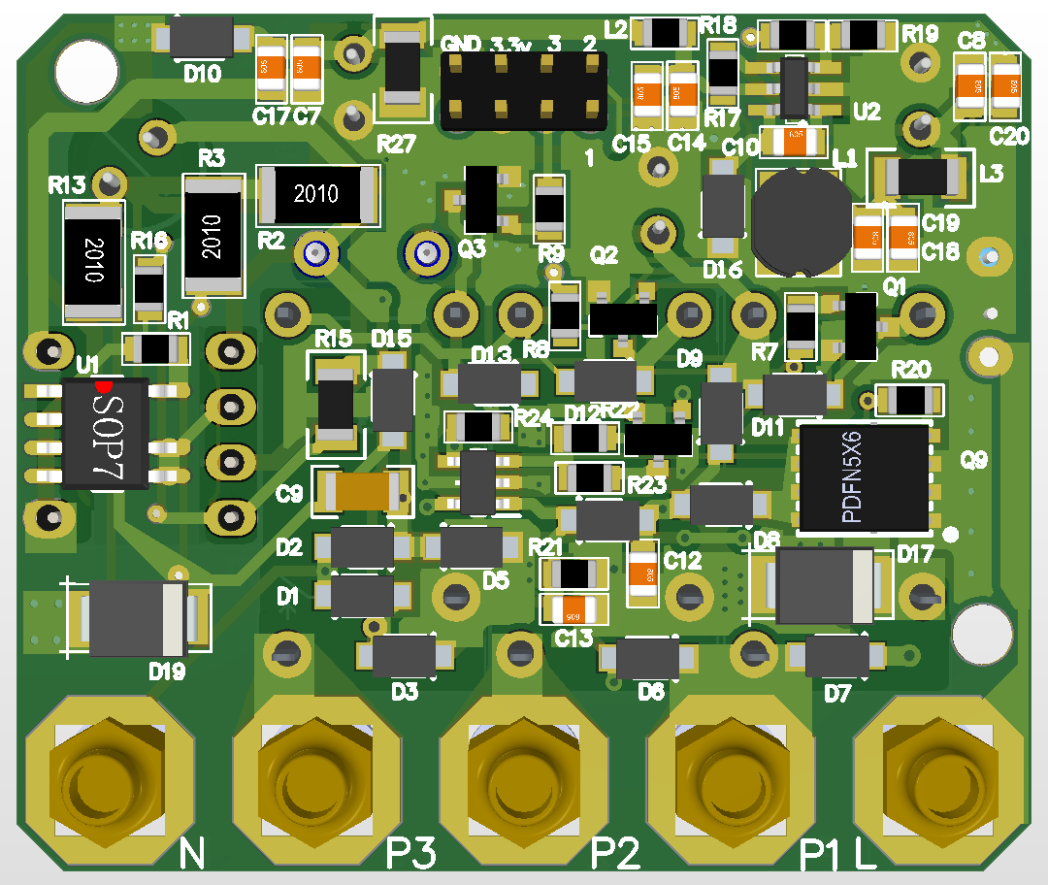
[picture p45: hardware/images/smart-touch-switch/pcb-powerboard-nonullrequired-3d-altium-2.png]
Reverse/detail view of no-neutral power-board render


*Reverse/detail view of no-neutral power-board render*

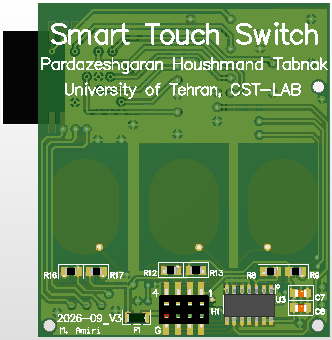
[picture p46: hardware/images/smart-touch-switch/pcb-touch-esp-3d-altium-2.png]
Additional capacitive touch PCB render


*Additional capacitive touch PCB render*

</details>

> **Electrical safety:** the power-board concepts involve mains-connected circuitry. The images document research prototypes and do not constitute installation instructions or evidence of regulatory compliance. Isolation, creepage/clearance, touch safety, thermal performance and enclosure requirements require proper verification before practical deployment.

## Flicker Measurement Device

Lighting flicker was characterized using a custom optical acquisition system and signal processing. Measurements can be transferred to a computer for **MATLAB-based time- and frequency-domain analysis**, including FFT-based characterization. An ESP32-based onboard processing approach was also considered.

### V1 — Phototransistor-Based Instrument

The constructed prototype uses a **phototransistor illuminance sensor**, signal conversion/interface circuitry, a microcontroller and a computer connection. A reduced phototransistor load resistance can improve response speed, but decreases signal amplitude, creating a noise-versus-bandwidth trade-off. Higher-speed operation may therefore require low-noise amplification and careful analog front-end design.

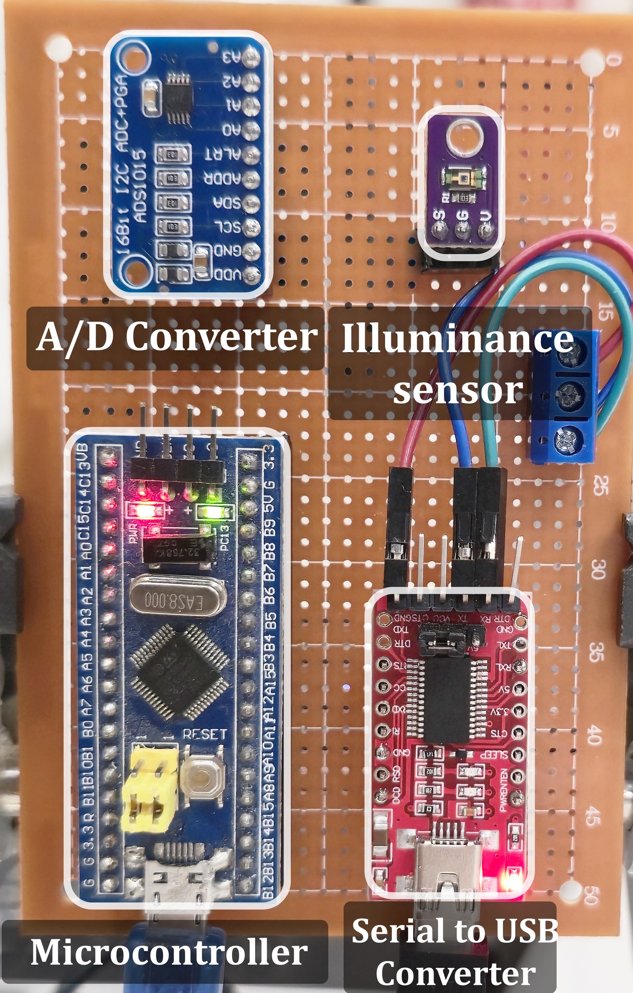
[picture p47: hardware/images/flicker-meter/assembled-v1.jpg]
Built V1 phototransistor-based flicker measurement prototype


*Built V1 phototransistor-based flicker measurement prototype*

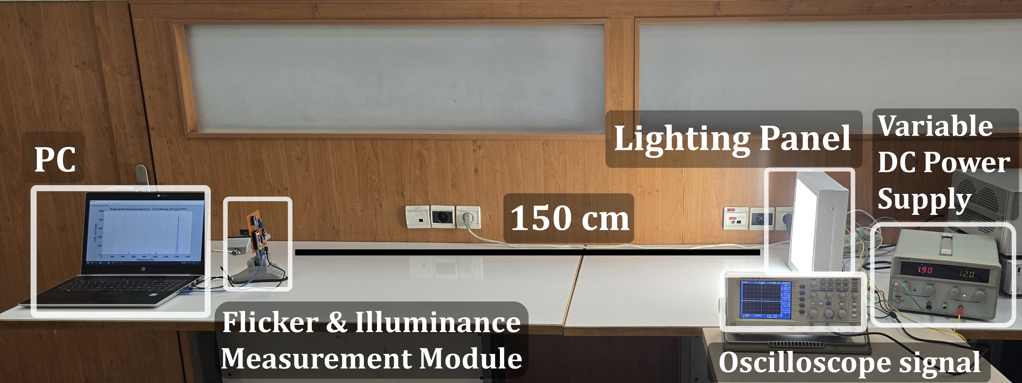
[picture p48: hardware/images/flicker-meter/test-setup.png]
Flicker measurement setup with PC, light source, oscilloscope and supply


*Flicker measurement setup with PC, light source, oscilloscope and supply*

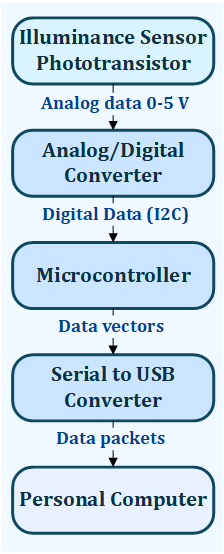
[picture p49: hardware/images/flicker-meter/block-diagram-v1.png]
V1 acquisition chain: phototransistor, MCU and USB transfer


*V1 acquisition chain: phototransistor, MCU and USB transfer*

### V2 — Proposed Photodiode-Based Architecture

A second conceptual architecture replaces the phototransistor with a **photodiode**, offering a potentially faster optical response. Its schematic/block diagram illustrates a possible amplification/ADC and wireless-processing chain.

**Status:** block-diagram design only. No physical V2 device, measured bandwidth or validated performance is claimed.

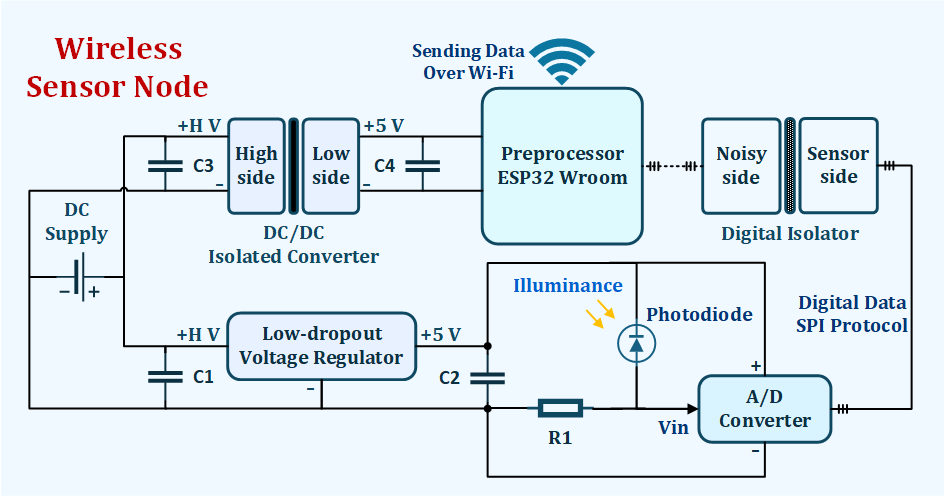
[picture p50: hardware/images/flicker-meter/block-diagram-v2.png]
Proposed V2 photodiode signal acquisition and wireless node


*Proposed V2 photodiode signal acquisition and wireless node*

## Related Documentation

[Main Project Overview](../README.md) · [Embedded Firmware](../firmware/README.md) · [Control and Optimization](../control-and-optimization/README.md) · [Signal Processing](../signal-processing/README.md)

**Related publications:** [Flicker-Free Smart Lighting Panel (SGC 2025)](https://doi.org/10.1109/sgc69320.2025.11372343) · [Frequency-Oriented Calibration (ICEE 2026)](https://doi.org/10.1109/icee70628.2026.11710520)
