Mostafaa-Amiri/smart-indoor-lighting-control-system/COPYRIGHT.md

# Copyright and Permissions

**Copyright © 2026 Mostafa Amiri. All rights reserved.**

This repository is published to showcase the Smart Indoor Lighting Control System research and engineering work. **It is publicly accessible, but no open-source or other general reuse license is granted.**

Unless otherwise stated or separately licensed, original source code, documentation, circuit diagrams, PCB designs, illustrations, photographs, and datasets for which Mostafa Amiri holds copyright may be viewed through this repository. Public availability does not, by itself, grant permission to reproduce, adapt, redistribute, or commercially exploit these materials.

For permissions beyond those provided by applicable law or GitHub's Terms of Service, contact the copyright holder through [GitHub](https://github.com/Mostafaa-Amiri).

Third-party components, libraries, and materials remain subject to their own applicable licenses and rights. This notice does not restrict uses permitted by law or by GitHub's Terms of Service.

For academic citation information, see [CITATION.cff](CITATION.cff) and the related publications in the main [README](README.md).
