Mostafaa-Amiri/smart-indoor-lighting-control-system/control-and-optimization/images/dashboard_auto_overview.png

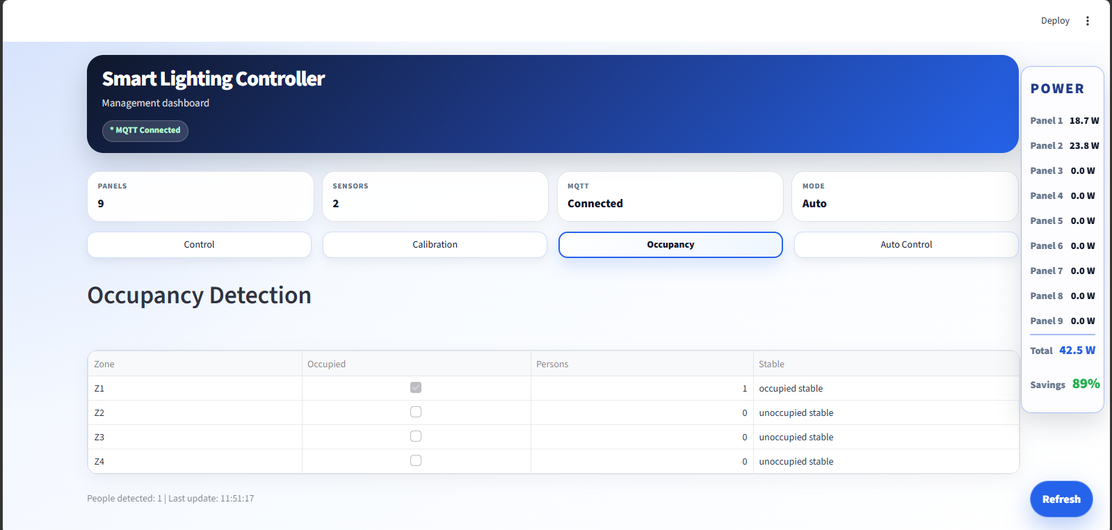
control-and-optimization/images/dashboard_auto_overview.png
