Mostafaa-Amiri/smart-indoor-lighting-control-system/results-and-media/README.md

# Results and Media

**Smart Indoor Lighting Control System**  
*CST Lab · University of Tehran*

## Overview

This section presents the experimental demonstration of the **Smart Indoor Lighting Control System** operating in the CST Lab testbed at the University of Tehran.

## Experimental Demonstration

The recording shows **daylight-aware, occupancy-responsive control** with a target illuminance of **400 lx** at the occupied desk. At the beginning, all lighting panels are off. The researcher moves between workstations to test different occupancy locations, and the system activates the appropriate panels according to the detected occupancy and available daylight.

The controller calculates panel dimming levels to meet the illuminance target while minimizing estimated electrical power. When a desk becomes vacant, its associated panels switch off after a **15-second delay**; the newly occupied workstation receives the required artificial lighting. At the end, all lighting panels return to the off state.

Watch the CST Lab smart lighting demonstration (https://youtube.com/shorts/Hcsu9ZKmqog?feature=share)

*Video: laboratory demonstration of occupancy-adaptive, daylight-aware lighting control. The person moving between desks is the researcher conducting the test.*

**[Watch the experimental demonstration on YouTube](https://youtube.com/shorts/Hcsu9ZKmqog?feature=share)**

## Related Documentation

[Main Project Overview](../README.md) · [Control and Optimization](../control-and-optimization/README.md) · [Hardware Development](../hardware/README.md)
