Mostafaa-Amiri/smart-indoor-lighting-control-system/firmware/bh1750-illuminance-sensor/gy30_nodemcu_OTA_v2/config.example.h

#pragma once
// Copy this file to config.h in the SAME directory as the .ino sketch.
// Edit config.h locally. NEVER commit config.h or share real credentials.
const char* WIFI_SSID = "YOUR_WIFI_SSID";
const char* WIFI_PASS = "YOUR_WIFI_PASSWORD";
const char* MQTT_HOST = "192.168.1.100"; // Example: IP of your own MQTT broker
